lambdamikel/MIDI-80/README.md

# MIDI/80 
## A MIDI Sound & Interface Card for the TRS-80 Model 1, III, and 4 

#### Hardware & Firmware: [Michael Wessel](https://www.michael-wessel.info/) 
#### Z80 Wizardry and TRS-80 Zmac Assembler Advisor: [George Phillips](http://48k.ca/) 
#### Beta Testers: [Jürgen Wich](https://homecomputerguy.de/en/) (Model 1 Version), [Joel Hilliard (Model III / 4 Version)](https://www.youtube.com/@joelhilliard8298)
#### Project Page: [www.michael-wessel.info/hardware.html](https://www.michael-wessel.info/hardware.html#midi-80)
#### License: GPL 3

## Latest News

### September 2026

**#septandy 2026: the external clock box drives TRACKER from a real
synthesizer.**

> ✅ **TESTED ON REAL HARDWARE.** The last unproven path in the system is
> proven. A Korg microKORG sends MIDI beat clock into the clock box, the
> box turns it into parallel port step pulses, and TRACKER on a real
> Model I follows it.

[**#septandy 2026 - MIDI/80 TRACKER Updates - External MIDI Clock
etc.**](https://youtu.be/hMu7oSfEjDg) shows all of it: the external clock
running the Tracker from the microKORG, the new demo songs, and MIDORG's
visual feedback.

MIDI clock and MMC are dense, and decoding them on the TRS-80 while it is
already scanning for note-ons is not affordable. So that work moved off the
machine: an Arduino Uno with a standard MIDI shield does nothing else but
turn the incoming clock into the TTL step pulses on the parallel port that
TRACKER has understood since last year - two wires and a series resistor
into the Centronics socket.

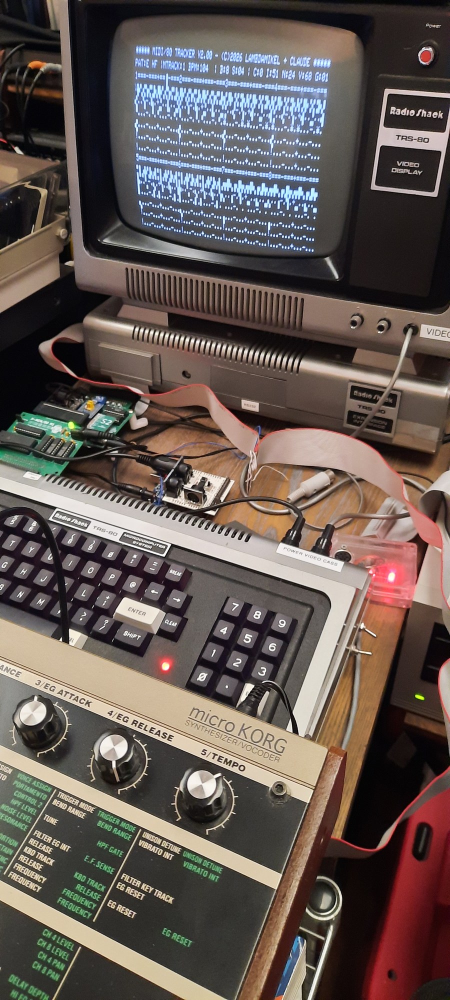
[picture p1: pics/clockbox-microkorg.jpg]
The clock box driving TRACKER on a Model I from a microKORG


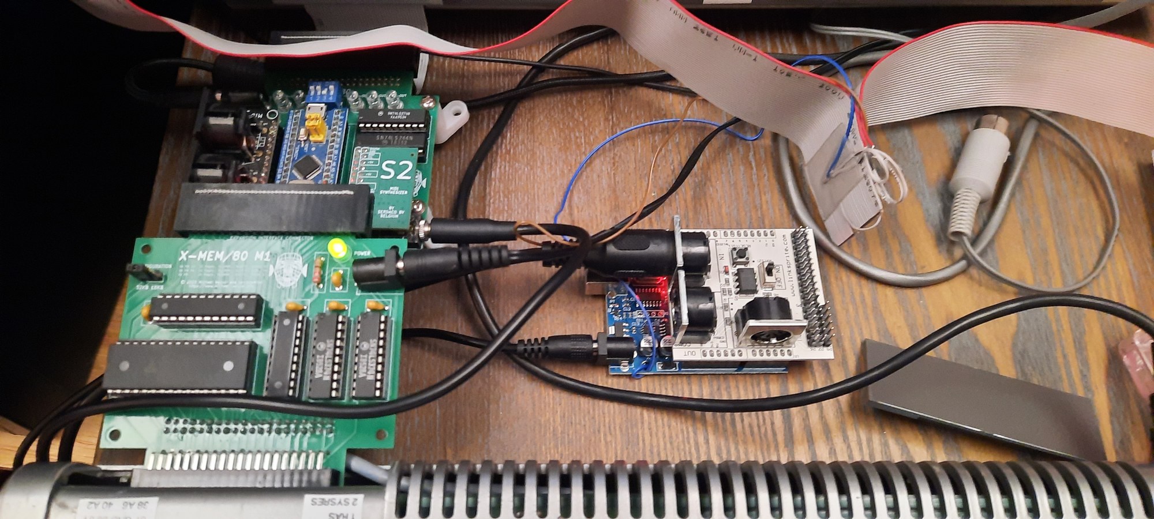
[picture p2: pics/clockbox-boards.jpg]
The MIDI/80 card, the X-MEM/80 and the Arduino clock box


The disks also carry new demo songs written with
[`tools/mksong.py`](tools/) - `BOOGIE`, `SEQUENCE`, `DRUMS` and the newest,
[`AURORA`](songs/), a Berlin school piece in D minor - and MIDORG now
lights up the keys on screen as they sound.

**TRACKER 1.99 and 2.00: MIDI clock & MMC transport output, and a much
faster tracker core.**

> ✅ **TESTED ON REAL HARDWARE.** TRACKER 2.00 has been run on an actual
> Model III driving a real MIDI/80 S2 Waveblaster module: playback,
> realtime MIDI recording, the MIDI panic and the disk prompts all work,
> and it "runs rock solid".
>
> The two concerns that were flagged here while this was emulator-only
> both came out fine, though the hardware did earn its keep:
> - **Video wait states, disabled in 2.00 on the Model III / 4** - no
>   visible hash or snow on a real CRT.
> - **The direct matrix keyboard scan** replacing the ROM call - fast and
>   pleasant for realtime note entry, and the reason recording feels
>   responsive. It did expose two real bugs that no emulator would have
>   found on its own, both since fixed: `@KEY` racing the scan (see
>   below), and command keys needing a release settle against contact
>   bounce.
>
> **Model I** has since been confirmed too, along with the keyboard fixes,
> **MIDORG V1.1**'s key highlighting, and the **`.hfe` images** booted from
> a Gotek on both machines.
>
> Each image format is verified where it is actually used: the `.hfe` files
> on real hardware, and the `.dsk` (JV3 / JV1) files under emulation, which
> is what they are for - a Gotek or HxC does not read them. Since the
> `.hfe` is produced from the `.dsk` by `hxcfe`, the filesystem inside is
> the same one either way, and booting the `.hfe` exercises it.
>
> The **external clock cable** from the Arduino clock box into the TRS-80
> parallel port has since been built, and it works: see the #septandy 2026
> entry above. Every path through the system is now hardware-verified.
>
> The tempo calibration behind the BPM readout has since been confirmed on
> hardware too: 32 bars of `BOOGIE` timed at **55.0 s** by stopwatch on a
> real Model III against **54.94 s** predicted, agreeing to within stopwatch
> accuracy. The old `BPM:` field would have implied 58.8 s for the same
> passage, nearly four seconds out - **that readout has now been corrected**
> (see below), and `BOOGIE` reads `BPM:140` rather than `BPM:130`.
>
> `TRACKER5/CMD` (V1.98) is unchanged and still on the disks as a
> fallback, but **2.00 is now the one to use** - it has been validated on
> real hardware, and it is the only version with MIDI clock output, the
> faster core and the time based tempo.

TRACKER can now act as a **MIDI master**: it transmits MIDI beat clock,
transport messages and MMC (MIDI Machine Control) over MIDI OUT, so a
DAW, drum machine or groovebox can follow the TRS-80 instead of the
other way round.

### What this means if you play live

Until now a TRS-80 running TRACKER was an island on stage: it kept its own
time, and nothing else could lock to it. With clock output it becomes the
master of the rig - press `P` and the drum machine, the groovebox and the
DAW all start with it and hold tempo with it. The `M` mode does the
reverse for setups where something else is the timing master and you only
want the TRS-80's transport to roll the other device.

The timing work matters here more than the numbers suggest. Step jitter
dropped from 1.96 ms to 0.46 ms and MIDI clock jitter from 28.75 ms to
4.40 ms, which nobody hears as such - but it is the difference between a
machine that stays locked to a drum machine across a four minute track and
one that drifts audibly out of it. The
[external clock module](firmware/midiclock-uno/) closes the loop the other
way, letting a MIDI master drive TRACKER's step clock at 0.096 ms
peak-to-peak.

**The `R` key cycles through four modes**, shown as a single character
in the status row:

| Status | Mode | What is transmitted |
| --- | --- | --- |
| (blank) | off | nothing |
| `C` | clock | `F8` timing clock + `FA`/`FC` transport |
| `B` | both | clock + transport + MMC |
| `M` | MMC only | MMC transport messages only, **no timing clock** |

The modes are separated because the two things are not equally
harmless. MMC is simply ignored by gear that does not speak it, but a
timing clock is not: anything set to external sync will start following
this machine's tempo the moment the clock appears. `M` is therefore the
mode to use when something else is the timing master and you only want
the `P` key to roll the other device's transport. (`FA`/`FC` are
suppressed in `M` as well - they are meaningless to a receiver that is
getting no clock from us.)

What gets sent, by event:

| Event | Bytes on MIDI OUT |
| --- | --- |
| Start playback (`P` or `!`) | `FA`, then `F0 7F 7F 06 02 F7` (MMC Play) |
| While playing | `F8` timing clock, 24 ppqn (6 per tracker step) |
| Stop | `FC`, then `F0 7F 7F 06 01 F7` (MMC Stop) |

MMC is addressed to device id `7F` (all call), so it reaches any
listening device without configuration.

A tracker step is a 16th note, so a quarter note is four steps and
exactly **six MIDI clocks are emitted per step**. The clock count is
drift free by construction: the downstream tempo cannot slowly walk
away from the tracker's own.

Sending rather than receiving is deliberate. Receiving MIDI clock would
mean polling the MIDI/80 FIFO fast enough never to miss an `F8`, from a
main loop whose pass duration varies by two orders of magnitude - the
tracker simply cannot observe an incoming clock precisely enough. It
*can* say exactly when its own step happened.

For the opposite direction - driving a TRS-80 **from** an external MIDI
master - there is now a companion
[**external clock box**](firmware/midiclock-uno/): an Arduino Uno with a
MIDI shield that converts incoming MIDI beat clock into the parallel
port step pulses TRACKER already understands in external clock mode.
Being dedicated, it timestamps every byte within microseconds instead
of missing clocks inside TRACKER's ~27 ms per-step blind window.

**The clock box is verified on real hardware**, on the bench and now in
place: driven by a Korg microKORG over an actual MIDI cable it tracked 276
consecutive steps with 17 microseconds of standard deviation and 0.096 ms
peak-to-peak jitter, and it has since been wired into a Model I and used to
drive TRACKER from that same microKORG.

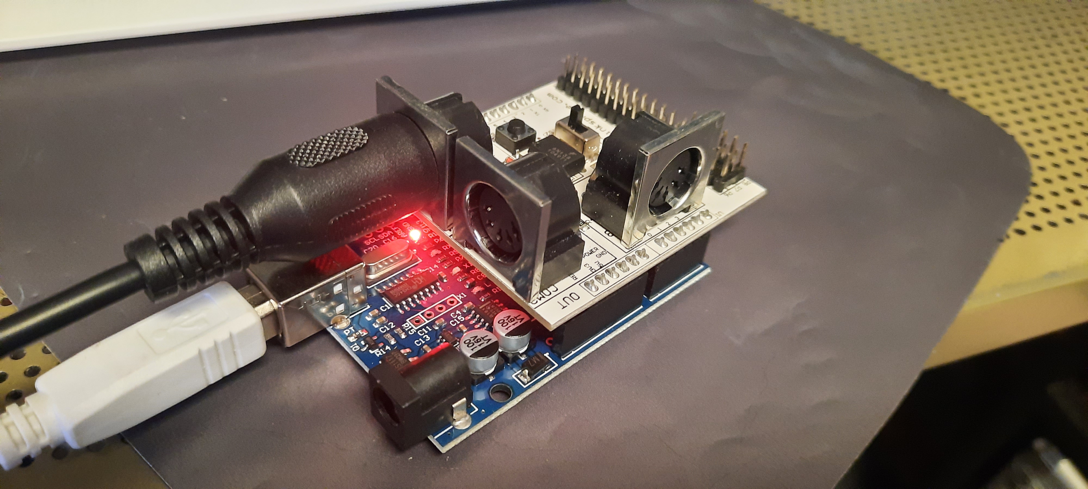
[picture p3: firmware/midiclock-uno/clock-module.jpg]
The clock module


**Wiring it is two wires**, and the series resistor is not decoration:
`D8` is a push-pull output, so if the pin it lands on ever turns out to be
an output too - a miscount on the connector, a bent pin touching a
neighbour - 220-470 Ω keeps the fight down to a few milliamps. It costs
nothing in signal integrity, since the TRS-80 input is TTL and draws
essentially no current.

```
   Arduino Uno                              TRS-80 Centronics
   -----------                              -----------------
   D8  o---------[ 220-470 ohm ]---------o  pin 21   BUSY   (input)
   GND o---------------------------------o  pin  2   GND
```

If you already built the TRS-80-to-TRS-80 sync cable, reuse it: leave the
end that plugs into the TRS-80 alone and take the two wires that went to
the *primary* machine to the Arduino instead - `Data 0` to `D8`, `GND` to
`GND`. That way you never have to identify pins on the TRS-80 side, since
that half is already proven. The [full pinout, the divisor jumpers and the
shield caveats](firmware/midiclock-uno/) are with the firmware.

**Note:** MIDI beat clock slaving is uneven across DAWs. Hardware
(drum machines, grooveboxes, most synths) follows it reliably. Ableton
Live and Bitwig are solid; Logic and Pro Tools are MTC oriented and are
poor or unsupported beat clock slaves. Check your own DAW before
relying on it.

#### TRACKER 2.00: tempo is now a real tempo

Until now `SPEED` counted main loop passes, so the step period was
whatever the work happened to cost - it changed with note density and
with anything that made the loop faster or slower. In 2.00 `SPEED` names
an actual period, and the status row shows a **real BPM readout**
instead of the raw hex delay count:

```
PAT:A SF | TRACK:1 BPM:236  | B:8 S:04 | C:0 I:01 N:24 V:7F G:08
```

The measured step period holds to a standard deviation of **0.46 ms**,
and the displayed BPM is within **0.2%** of the real playback rate.
Tempo range is roughly **60 to 550 BPM** counted in 16ths, with
`SPEED:$2A` landing at 236 BPM - about where stock 1.98 sat, so
existing songs play close to as before.

2.00 is also substantially faster, from two changes found by profiling
the step in the trs80gp bus trace:

- **Video wait states are now disabled on the Model III / 4.** They were
  costing **128 T-states per `LDIR` byte instead of 21** - a 6x penalty
  on every screen write. `showplaycursor` alone dropped from 8.02 ms to
  1.39 ms. (The Model I never executed that path.)
- **The ROM `@KBD` keyboard scan was replaced by a direct matrix scan.**
  `@KBD` was 55,836 T-states per step - about 41% of the entire step.
  The replacement costs roughly a third of that.

Together with the time based tempo these left enough headroom to hold
the clock steady: jitter between consecutive `F8` bytes came down from
28.75 ms in the first working version to **4.40 ms**, with a standard
deviation of 0.94 ms.

#### Measured improvements

All figures from the trs80gp cycle-accurate bus trace, Model III at
2.02752 MHz, empty pattern, `SPEED:$2A`. **Emulator measurements, not
yet confirmed on real hardware** (the clock box table below is the
exception - that one is hardware).

**Timing stability**

| | 1.98 | 2.00 | |
| --- | --- | --- | --- |
| Step period jitter (std dev) | 1.96 ms | **0.46 ms** | **4.3x steadier** |
| MIDI clock jitter (peak-to-peak) | 28.75 ms * | **4.40 ms** | **6.5x tighter** |
| MIDI clock jitter (std dev) | — | 0.94 ms | |
| Clocks per step | — | **exactly 6.00** | drift free by construction |
| Tempo shift when sync enabled | 17.9% | **0.1%** | **179x better** |
| BPM readout error | no readout | **0.17%** | 236 shown vs 236.4 measured |

\* the first working version of the feature, before the time weighted rewrite

**Raw speed**

| | 1.98 | 2.00 | |
| --- | --- | --- | --- |
| `@KBD` keyboard scan, per step | 55,836 T | **19,068 T** | **2.9x** (-66%) |
| `showplaycursor`, per step | 16,259 T | **2,818 T** | **5.8x** (-83%) |
| `LDIR`, per byte | 128 T | **21 T** | **6.1x** (-84%) |
| Work per step | 63.53 ms | **41.40 ms** | **1.5x** (-35%) |

The tracker does the same work in 65% of the time, which is what pays
for a real time based tempo while still leaving roughly 22 ms of slack
per step at 236 BPM. Total cost: **+808 bytes** (8325 -> 9133, +9.7%),
leaving about 2200 bytes before the data region.

**The external clock box** (hardware verified against a Korg microKORG)

| | |
| --- | --- |
| Jitter over 276 consecutive steps | **0.096 ms** peak-to-peak, **std dev 17 microseconds** |
| versus TRACKER's own clock output | **46x tighter** |
| versus TRACKER's 27 ms blind window | **281x tighter** |

**Two caveats on the numbers.** The "4.3x steadier" step period comes
from a six step sample in the profiling trace - the strongest claim in
the table and also the thinnest data; the clock jitter figures come from
runs of 130 to 280 steps and are solid. And every tracker figure is
emulator measured: cycle accurate, but still an emulator.

The two findings worth more than the table: the full screen `LDIR`
redraw that looked like the obvious suspect was **0.5% of a step** and
innocent all along, while a single commented out `and a,~$20` was
costing **6x on every video write** and the ROM keyboard call was eating
**41% of the machine**.

#### Keyboard: `@KEY` no longer races the direct scan

Reported from real hardware: pressing `H` would flash the help page for a
fraction of a second and then lose it. It looked like contact bounce, but it
reproduces exactly under emulation, where there is no bounce at all — a press
held longer than about 130 ms always loses the page, a quick tap never does.

2.00's direct matrix scan reacts to a key in roughly a millisecond, while the
interrupt-driven DOS keyboard driver only scans every 25 ms or so. Any press
held longer than one DOS scan therefore also lands in the DOS type-ahead
buffer, and the `call @KEY` that waits to dismiss the help page reads that
buffer — finding the very `H` that opened it. The same race auto-answered the
`Y/N` prompts on load, save and quit, and the copy-pattern and disk-error
prompts.

All four `@KEY` calls now use `waitkey`, which waits on the tracker's own
scan and so never consults the DOS buffer. It first insists the keyboard is
fully released, so the keystroke that opened a prompt cannot answer it.

`kbdscan` also gained a release settle (`KBDSETTLE`, ~20 ms of quiet before
the same key may be reported again), which does address genuine contact
bounce: without it the scan is fast enough to see a bouncing contact re-close
and count one press several times. The settled path costs 28 T against the 27
it replaced, so the step timing is unchanged — measured 139.68 BPM against
139.80 before, with jitter slightly improved. `datalength` is unchanged, so
existing `DUMP` files still load.

#### Stopping now silences the notes

Reported from real hardware: stop a song and notes hang until the sound
module is reset. This one is not the module's fault and not a MIDI panic
problem — the panic (the `0` key, `ALL NOTES OFF`) works fine. Stopping
simply never sent any note offs.

Both stop paths, `showstartstop` (the `P` and `!` keys) and `stopsong` (the
end of a song), sent only the `FC` MIDI Stop transport byte and set the
status flag. Any note whose note off was scheduled for a later step never
got one, so it sounded forever. Starting playback *did* call `midipanicr`,
which is why the notes cleared as soon as you started again.

Both paths now send the panic on the way out, so a stop is silent. Fixed in
1.99 and 2.00 alike; verified on the MIDI stream captured from the emulated
machine, which now shows a second 16-channel All Notes Off at the stop and
leaves nothing sounding.

#### The BPM readout now tells the truth

2.00's `BPM:` field used to be derived from `steptarget`, the value
`advanceclock` compares the step accumulator against. But the accumulator
over-counts idle main loop passes, so the real step is shorter than the
target by an amount that grows with tempo: the readout was honest around
tempo 40 and read up to 10% slow at tempo 200.

It is now derived from the measured step period instead:

```
divisor = 3893 + 97 * tempo        (16 T-state units)
BPM     = 1900800 / divisor        Model III;  1646800 Model I
```

good to within 0.3% across the whole tempo range, with the result rounded
rather than truncated. `BOOGIE` reads `BPM:140` against a true 139.8.

**`steptarget` is deliberately untouched**, so this is a display change
only - the playback timing is bit-for-bit what it was, verified as an
identical 217733 T-state step period before and after. Changing
`TEMPOBASE` would have been the wrong fix: it would have shifted the
actual tempo and de-tuned every existing song along with the demo songs.

The Model I runs about 1% slower per step in T-states than the Model III -
same code, slightly different per-model branches - which is absorbed into
the Model I constant rather than needing a second slope. Both are confirmed
on real hardware: 32 bars of `BOOGIE` timed at 55.0 s on a Model III
(54.94 s predicted) and 63.0 s on a Model I (63.4 s predicted), reading
`BPM:140` and `BPM:121` against true values of 139.6 and 121.9.

1.99 has no BPM readout, so nothing changed there.

#### Bootable disk images

Ready-to-run LDOS images containing `TRACKER5/CMD` (1.98),
`TRACKER6/CMD` (1.99) and `TRACKER7/CMD` (2.10) side by side, so the old
and new versions can be compared on the same machine:

| Model | Disk image | Gotek / HxC |
| --- | --- | --- |
| III / 4 | [`TRACKER.DSK`](trs-80/model-3/dsk/TRACKER.DSK) (JV3) | [`TRACKER_DSK.hfe`](trs-80/model-3/hfe/TRACKER_DSK.hfe) |
| I | [`tracker.dsk`](trs-80/model-1/dsk/tracker.dsk) (JV1) | [`tracker_dsk.hfe`](trs-80/model-1/hfe/tracker_dsk.hfe) |

Boot, then just type `TRACKER7` (or `TRACKER6`, or `TRACKER5`).

#### Demo songs

Three demo songs ship as ready-to-play disks that also carry `TRACKER7/CMD`
— boot, type `TRACKER7`, press `L` then `Y`:

| song | style | plays at |
| --- | --- | --- |
| `BOOGIE` | 12 bar blues shuffle in C — bass, two organ voices, lead, drums | 140 BPM |
| `SEQUENCE` | Berlin school 16th note sequencer in A minor, builds over 5 patterns | 120 BPM |
| `DRUMS` | six voice drum machine, all six tracks on channel 10 | 125 BPM |

| Model | Disk images | Gotek / HxC |
| --- | --- | --- |
| III / 4 | [`BOOGIE.DSK`](trs-80/model-3/dsk/BOOGIE.DSK), [`SEQUENCE.DSK`](trs-80/model-3/dsk/SEQUENCE.DSK), [`DRUMS.DSK`](trs-80/model-3/dsk/DRUMS.DSK) | [`BOOGIE_DSK.hfe`](trs-80/model-3/hfe/BOOGIE_DSK.hfe), [`SEQUENCE_DSK.hfe`](trs-80/model-3/hfe/SEQUENCE_DSK.hfe), [`DRUMS_DSK.hfe`](trs-80/model-3/hfe/DRUMS_DSK.hfe) |
| I | [`boogie.dsk`](trs-80/model-1/dsk/boogie.dsk), [`sequence.dsk`](trs-80/model-1/dsk/sequence.dsk), [`drums.dsk`](trs-80/model-1/dsk/drums.dsk) | [`boogie_dsk.hfe`](trs-80/model-1/hfe/boogie_dsk.hfe), [`sequence_dsk.hfe`](trs-80/model-1/hfe/sequence_dsk.hfe), [`drums_dsk.hfe`](trs-80/model-1/hfe/drums_dsk.hfe) |

The raw song files and `.MID` renderings are in [`songs/`](songs/), including
`*-TRS80.mid`, captured from the emulated machine's actual port 8 output by
tracing every `out (8),a` — so those files are literally what the TRS-80 put
on the wire. All 817 note-ons across the three songs matched the composition
on channel, note, velocity and timing.

Songs are written with [`tools/mksong.py`](tools/); the format is documented
in [`tools/README.md`](tools/). One caveat worth reading before trusting the
`BPM:` display: the readout is accurate at fast tempos but reads up to ~10%
slow at the slow end, so these songs play faster than the number on screen
says. [`songs/README.md`](songs/README.md) has the measurements.

These were built with [`tools/ldoswrite.py`](tools/), a small LDOS image
writer added for the purpose — the usual tool for this, `trswrite.exe`
from TRSTOOLS, is a Windows binary whose original download site is now a
parked domain. The `.hfe` files were produced from the `.dsk` images with
`hxcfe`, exactly as in the [midibatchconv](midibatchconv/) workflow.

Two versions are provided:

- [`TRACKER7/CMD`](trs-80/zmac/zout/tracker7.cmd) (**V2.10**,
  [source](trs-80/zmac/tracker7.asm)) - everything described above.
- [`TRACKER6/CMD`](trs-80/zmac/zout/tracker6.cmd) (**V1.99**,
  [source](trs-80/zmac/tracker6.asm)) - MIDI clock and MMC output only,
  keeping the 1.98 core: ROM keyboard scan, video wait states enabled,
  and the original `SPEED` delay count. Kept as a fallback and for the
  smallest possible change from 1.98, though the concern that motivated
  it did not materialise - see below.

**2.00 has now been tested on real hardware**, on a Model III and a
Model I. The worry recorded here previously was that disabling video wait
states might produce visible hash or "snow" on a real CRT, where an
emulator would show none. It does not: the display is clean, and 2.00 is
the version to use. A **Model 4** has not been tried, and the wait state
bit is a Model III/4 thing, so if you run one and see artifacts, 1.99 is
still there.

The keyboard scan deliberately has **no typematic repeat**: a repeating
toggle key such as `P` would flip playback on and off many times a
second. Cursor keys therefore need a tap per step. It also waits for the
contacts to stay open for about 20 ms before accepting the same key
again - without that the scan is quick enough to catch a bouncing contact
re-closing and count one press several times, which made command keys
feel hair triggered on real hardware.

### February 2026

[Joel Hilliard aka DOWNPOLY](https://www.downpoly.com/)
released his new album, `TETHER_`: 

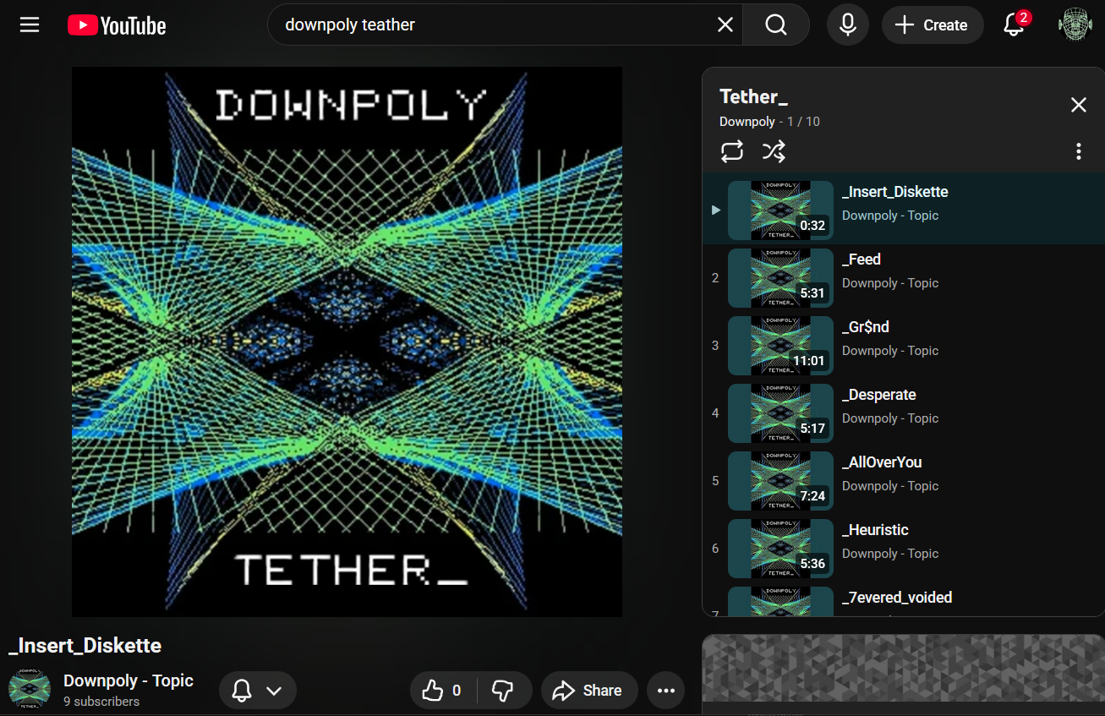
[picture p4: pics/tether_.png]
Tether


Unlike his previous album where MIDI/80 and TRACKER were 
mainly used for drums (it couldn't do more back then!), 
he is now increasingly utilizing it for full backing tracks 
on his songs (for bass, melodies, chords, ...). 
By now, TRACKER is a full-fledged 6channel multi-timbral
MIDI sequencer (organized into 26 pages which can be 
flexibly sequenced in song mode). 
More MIDI channels can be realized by synchronizing
multiple TRACKERs running on dedicated TRS-80s, 
via the parallel port sync cable (see below). Joel
is typically using 2 to 3 synchronized TRACKERS for his work. 
See below for more details. 

Please support [his work on Spotify](https://open.spotify.com/artist/7oj8N7mM6rrZCQnkTO5Ndb?si=y26EeWk6QDWjdPfHtQ730w) 
if you like [his songs on YouTube](https://www.youtube.com/channel/UCPh03Dpo_xX-oRaOAVRYgyw) (also see [here.](https://www.youtube.com/@downpoly))

### October 2025

- Playback of extremely large MIDI files is now possible - "Karn Evil
9" by "Emerson Lake & Palmer" requires 15 16 KB segments. This
requires a Gotek floppy emulator and some tricky 80-track disk
images. Thanks to folks on the TRS-80 Discord for helping me with
these. There is a new playback program
[`BIGLOAD/CMD`](trs-80/zmac/zout/BIGLOAD.CMD) which loads `/MID` files
with alphabetic suffixes (`A` - `Z`). Here are demo disks for the
[Model 1](trs-80/model-1/dsk/elp.jv3) (and
[`.HFE`](trs-80/model-1/hfe/elp.hfe)) and the [Model
III](trs-80/model-3/dsk/ELP.JV3) (and
[`.HFE`](trs-80/model-3/hfe/ELP.HFE)). An
[X-MEM/80](https://github.com/lambdamikel/x-mem-80) is required; use
the 16KB (X-MEM/80) mode. Enjoy - here is a [YT video.](https://youtu.be/6bADL48qsmo)

[Source code of `BIGLOAD/ASM`.](trs-80/zmac/bigload.asm)

To create your own very large MIDI song playback disk, just use these
disk images as blueprints and exchange the `SONGA/MID` ...
`SONGO/MID` files (you can go up to `SONGZ/MID`). The [MIDI
converter](converter/) still creates `SONG0/BIN` to `SONG<n>/BIN`
segments, so you need to rename them to be loaded with `BIGLOAD/CMD`.

### September 2025

- Playback of large MIDI files is now possible: [X-MEM/80 makes this
possible.](https://github.com/lambdamikel/x-mem-80) X-MEM/80 is a new
512 KB (paged) RAM extensions for the Model 1 and Model III that is
"plug & play", i.e., requires no hardware modifications.  Here is a
[demo video (playback of a very large MIDI
file)](https://www.youtube.com/watch?v=HZcZIu-G5TI). The details
and software as well as disk images can be found [here, on
the X-MEM/80 repo.](https://github.com/lambdamikel/x-mem-80?tab=readme-ov-file#midi80--x-mem80-software)

- [Joel Hilliard aka DOWNPOLY](https://www.youtube.com/@downpoly)
presented MIDI/80 and its software (Tracker, MIDORG, MIDI Playback
etc.) at [Tandy Assembly 2025 in Springfield,
Ohio.](https://www.youtube.com/live/VoPTrOpMQ2E?feature=shared) Great
talk, Joel! Also, a [DOWNPOLY Live
Performance](https://www.youtube.com/live/QNZUELyjySw?feature=shared)
is scheduled as well.

### August 2025

- I demoed MIDI/80 and the MIDI tracker playing a DOWNPOLY track at
  this year's Vintage Computer Festival West in Mountain View. MIDI/80
  was primarily driven by [TRS-IO++,](https://github.com/apuder) but I
  also had one connected to my Model III.  Also on display was
  [Talker/80.](https://github.com/lambdamikel/Talker-80) Here is a
  YouTube video showing [my table.](https://youtu.be/WiYWCjRBuf8)

### June 2025

- Thanks to Peter Kirn from the "cdm (create digital music)" blog for
  writing a comprehensive article about MIDI/80, Downpoly's great
  music, and the software that we wrote for it: ["Radio Shack’s TRS-80
  now has polyphonic MIDI and a
  tracker"](https://cdm.link/radio-shack-trs-80-tracker/)

- Thanks to Hackaday (Levin Day) for covering [MIDI/80 on the front page:](https://hackaday.com/2025/06/01/its-midi-for-the-trs-80/):

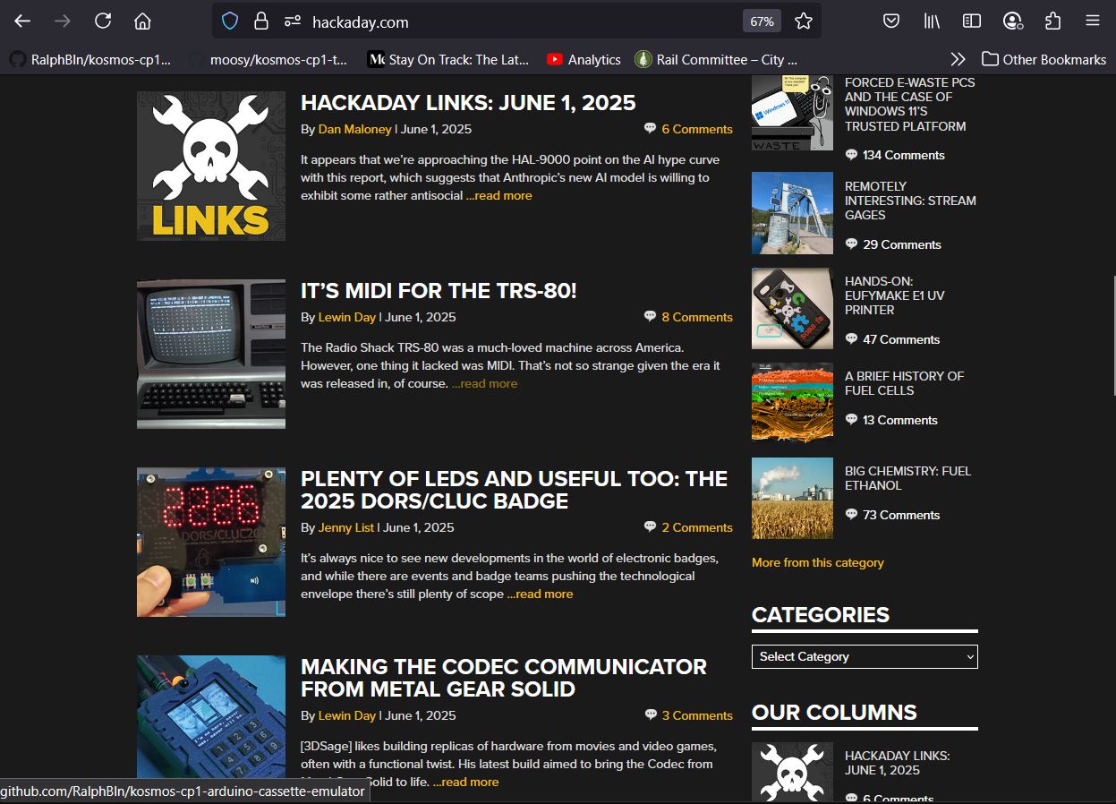
[picture p5: pics/hackaday-frontpage.jpg]
Hackaday 1


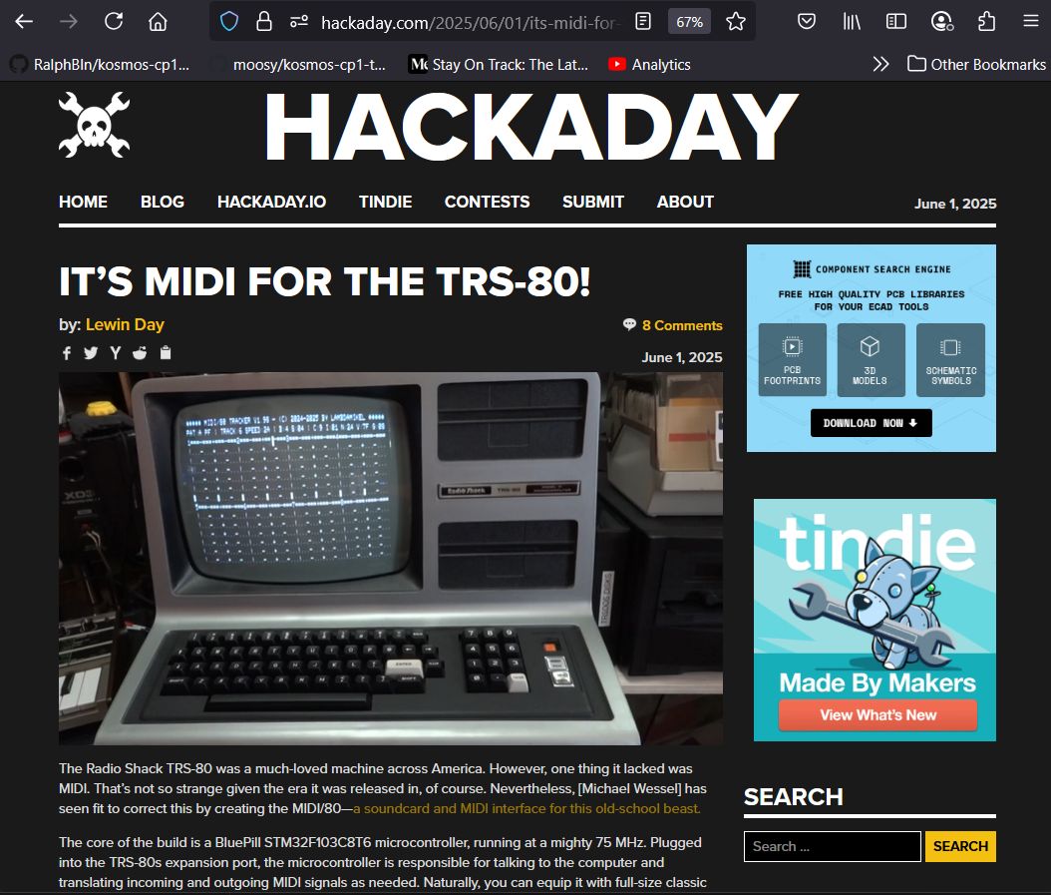
[picture p6: pics/hackaday-side-a.jpg]
Hackaday 2


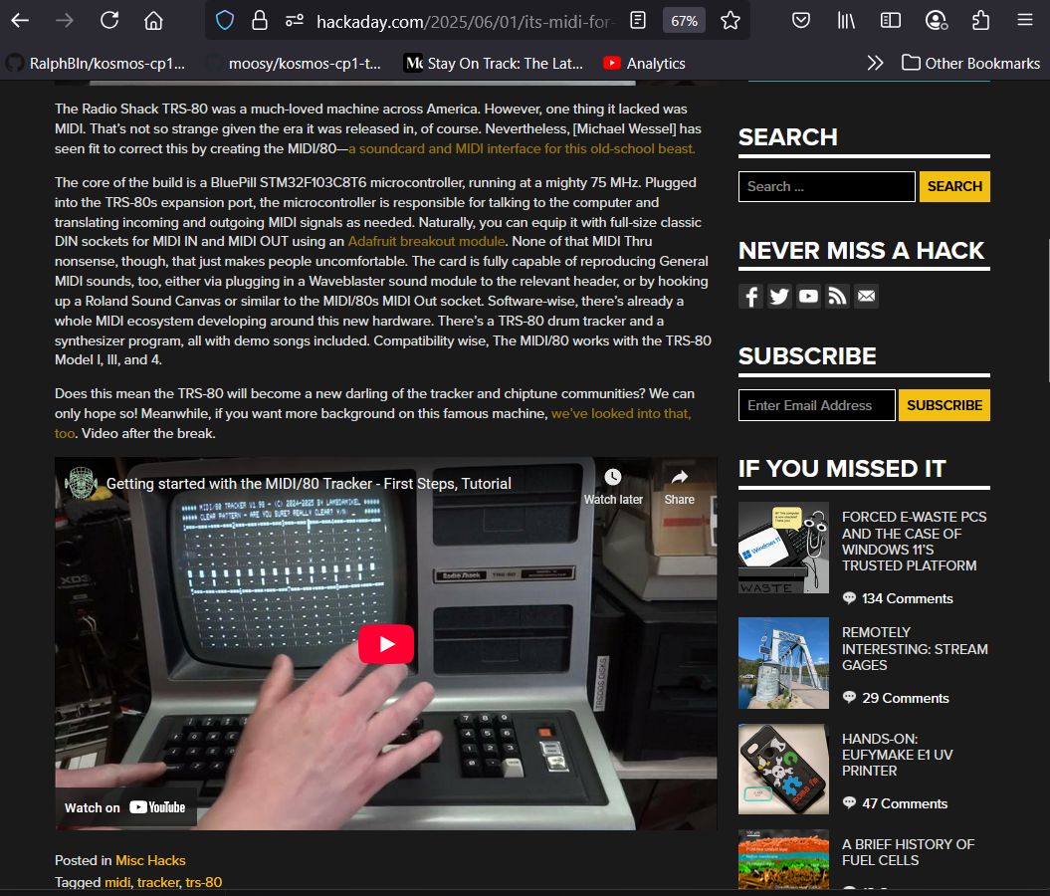
[picture p7: pics/hackaday-side-b.jpg]
Hackaday 3


### April 2025

As suggested by a recent customer, David, I have made a little
[Tracker 1.98 tutorial](https://youtu.be/nm6d1EbCBgk), good enough for 
first steps / getting your feet wet.

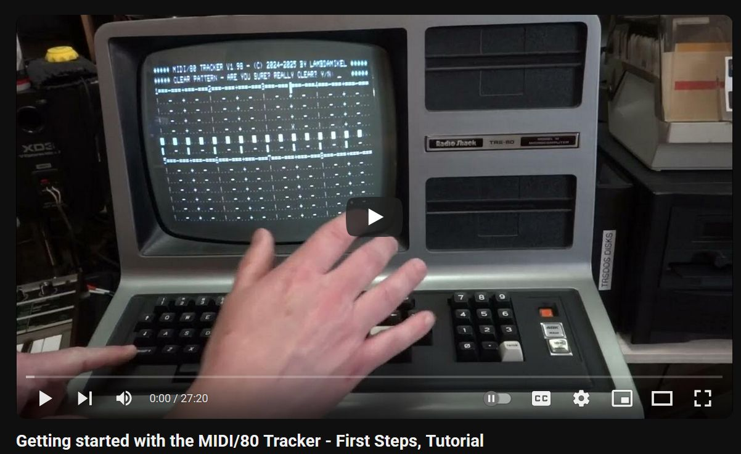
[picture p8: pics/tutorial.jpg]
Tracker 1.98 Tutorial


DOWNPOLY is using multiple Tracker 1.98 by now, synchronized over the
parallel port cable - check out [his YouTube
video!](https://youtu.be/Pxf6AB6l7uU)

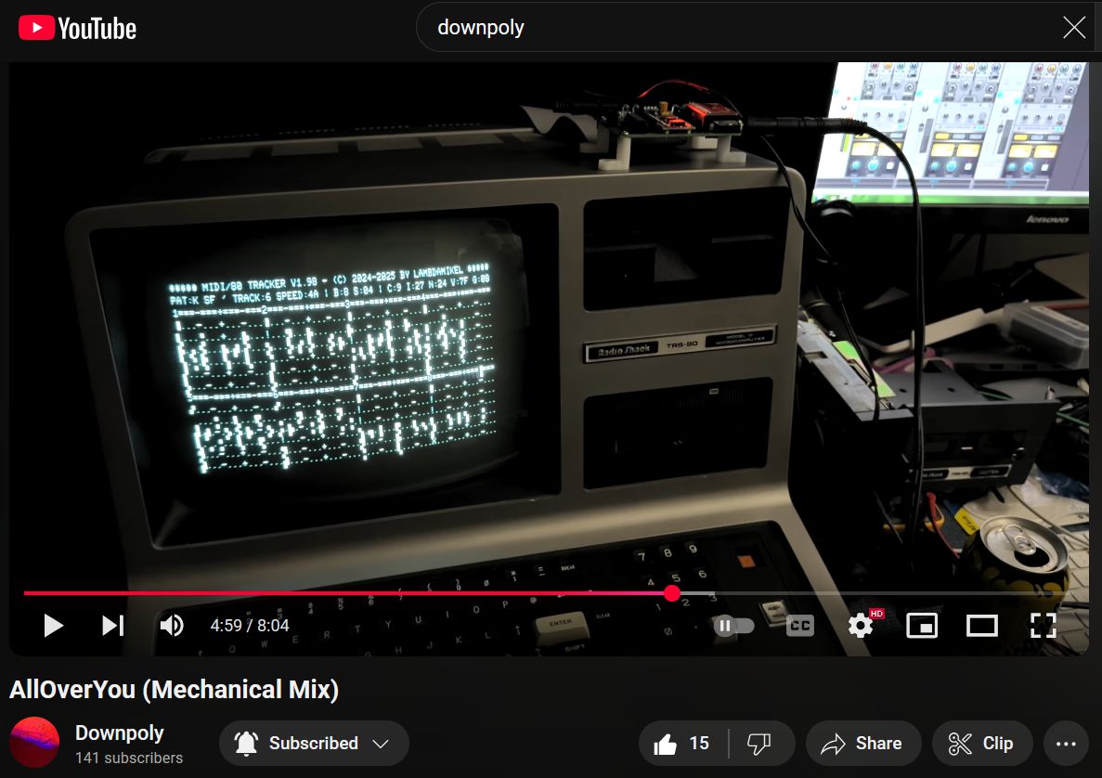
[picture p9: pics/downpoly-mechanical.jpg]
Downpoly Mechanical Mix 1


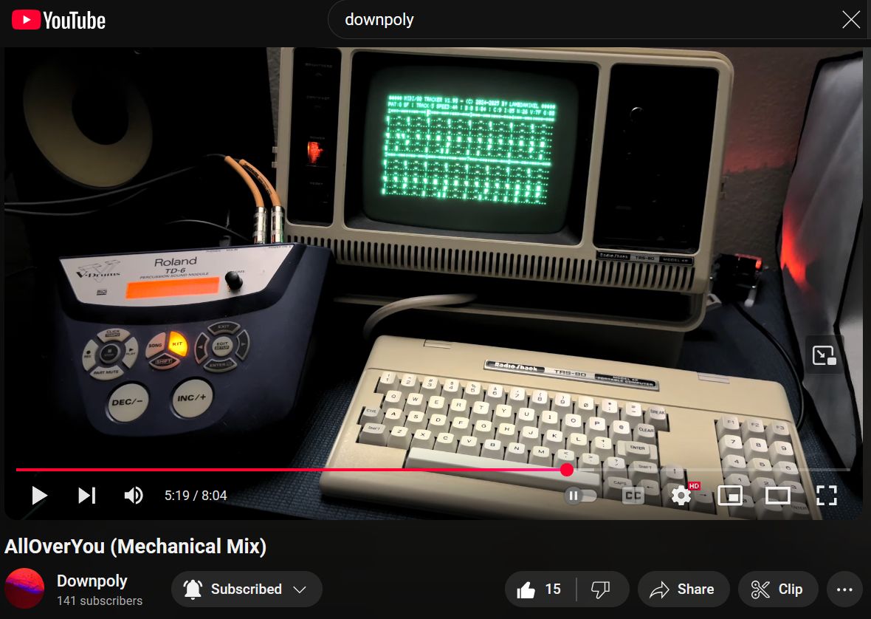
[picture p10: pics/downpoly-mechanical2.jpg]
Downpoly Mechanical Mix 2


### March 2025

It is now possible to synchronize multiple Trackers running on
different machines:

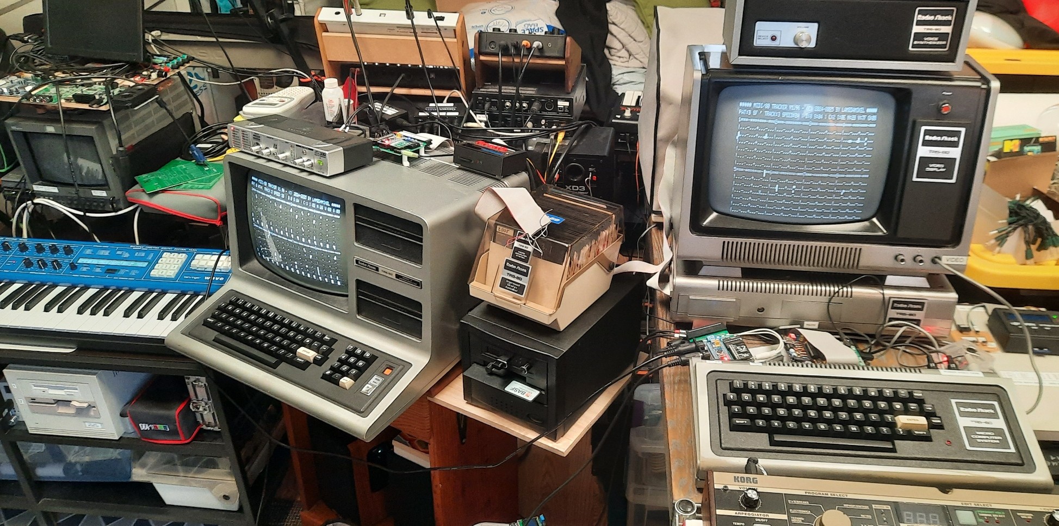
[picture p11: pics/sync.jpg]


Here is a [demo video](https://youtu.be/gPQqAGCHiV0). 

The latest version of the Tracker, Version 1.96 (`tracker5/cmd` on the
disk images) is now sending an external clock signal over the parallel
port, on `Data 0`. Another TRS-80 Tracker can then be configured to
latch on to this external clock by setting it into *external clock
mode* with the `'` key. The receiving TRS-80 Tracker is called the
secondary, and the clock generating Tracker the primary. Enable the
external clock mode on the secondary with the `'` key. Then start
playback as usual, in pattern (`P`) or song playback mode (`!`). As
usual, you can always refer to the help page for key bindings (`H`).
The secondary Tracker is frozen until it starts receiving the clock
signal from the primary Tracker via the parallel port cable; the tempo
setting of the secondary will be disregarded, as the tempo is
determined by the external clock from the primary. External clock can
be en- and disabled using the `'` at any time; also, with the
exception of the tempo setting, recording and all the other Tracker
operations and settings work identical as if the internal clock was
used.

External clock:

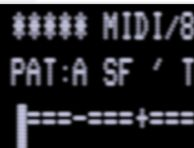
[picture p12: pics/extclock.jpg]
External Clock


Internal clock:

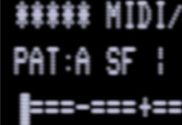
[picture p13: pics/intclock.jpg]
Internal Clock


To make the cable, simply connect the Centronics ports of the two
machines as follows: `GND` to `GND` (e.g., Centronics pin 2; note that
there are multiple options for `GND`), and the `Data 0` output
(Centronics pin 3) of the primary to the `BUSY` input (Centronics pin
21) of the secondary. And easy way to construct the cable is to cut
two TRS-80 printer cables in half, and solder the wires together: 

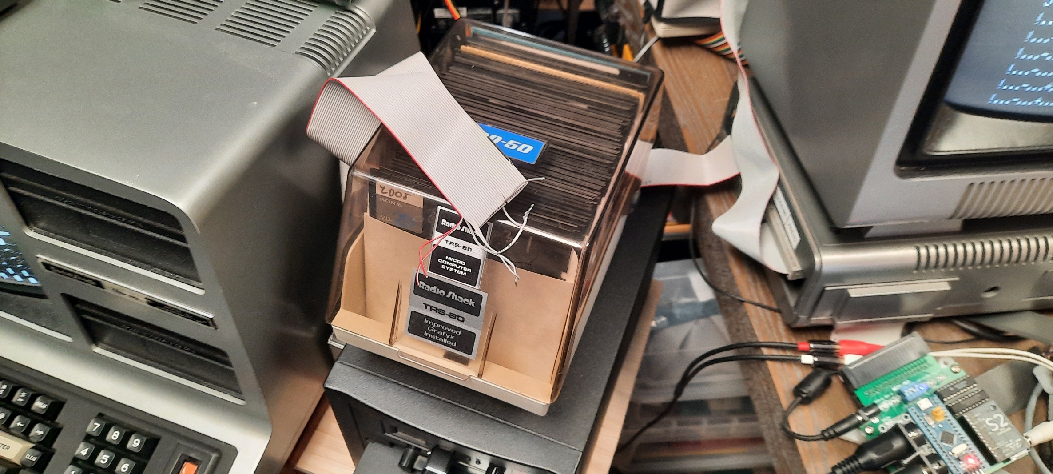
[picture p14: pics/cable.jpg]
Clock Cable


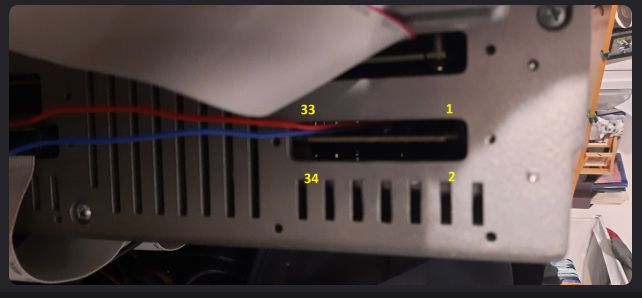
[picture p15: pics/parport.jpg]
Printer Port Model III


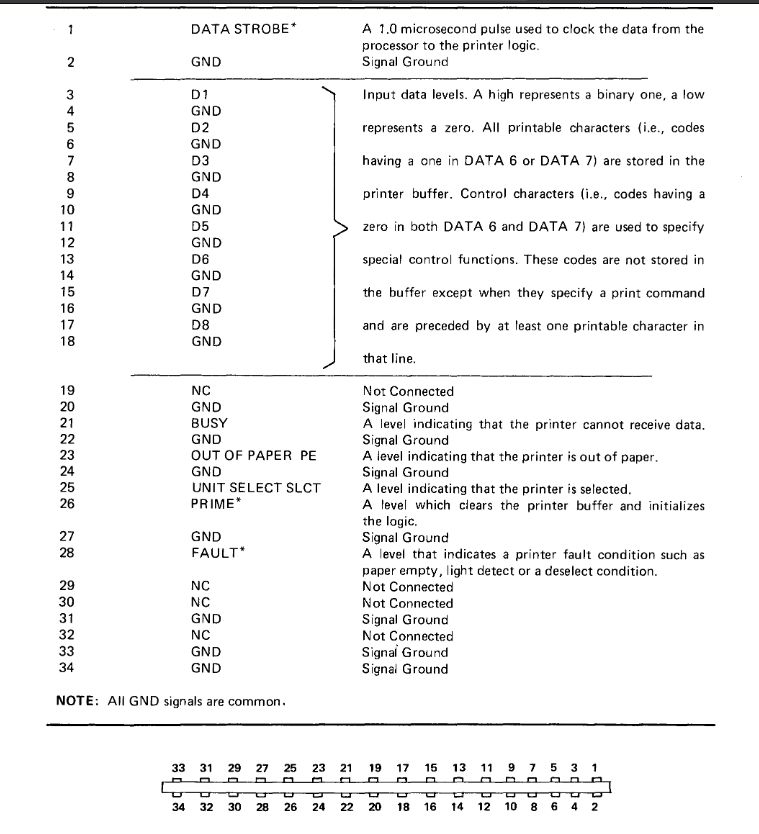
[picture p16: pics/printerport.jpg]
Printer Port Model I


### March 2025

Since March 21st I am proud owner of a Behringer Wave! I always
admired [the PPG Wave](https://en.wikipedia.org/wiki/PPG_Wave) created
back in the day in 1981 by [Wolfgang
Palm](https://en.wikipedia.org/wiki/Wolfgang_Palm), inventor of [Wave
Table Synthesis](https://en.wikipedia.org/wiki/Wavetable_synthesis),
in my birth-town [Hamburg,
Germany.](https://en.wikipedia.org/wiki/Hamburg) It's utterly amazing
what he achieved and accomplished with so little - he didn't even have
a C-compiler for software development. All the firmware / software for
his synths was programmed in bare-metal 6809 assembly.

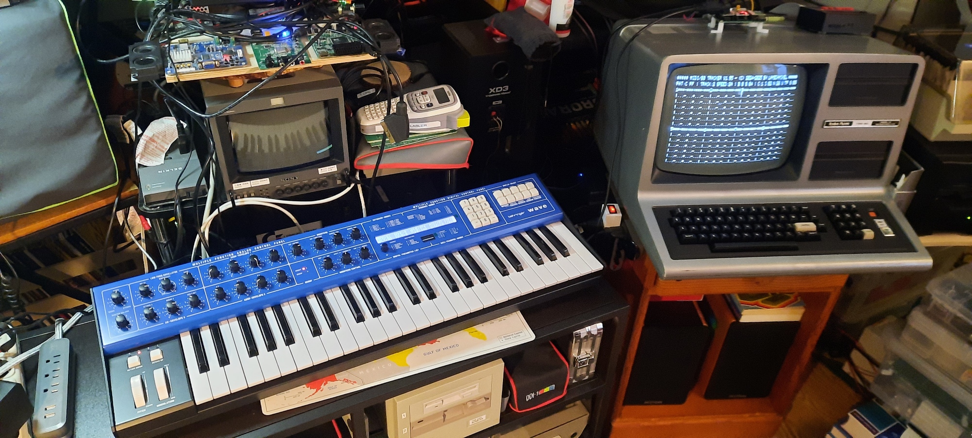
[picture p17: pics/wave.jpg]
Behringer Wave


Thanks to Behringer for cloning / re-creating the PPG Wave, and for
making it affordable! So everybody can experience the magic of this
legendary iconic influential synth now, for an extremely fair price. I
couldn't be more happy with it - the build quality is excellent
(enclosure is solid sheet metal!), the keyboard surprisingly good for
the price, and it even has aftertouch. The sound is excellent as well,
and it really reproduces the original sound quite faithfully as far as
I can tell. I believe the recreated Curtis filter chip plays a key
role here.

I am super happy with the Behringer Wave, as it allows me to make
music that sounds like Tangerine Dream and Depeche Mode from the early
1980s. [This video features my first steps with it, using Tracker 1.95
in song mode.](https://youtu.be/P_UCIXRl1cc)

### February 2025

Thanks to [Jürgen Wich](https://homecomputerguy.de/en/), who created a [new batch tool](midibatchconv/) that makes bulk creation of MIDI song disks a breeze! Check out his awesome new [MIDI Conversion Tools for MIDI/80 and TRS-80](midibatchconv/README.md)! His software tool suite can be found [here](midibatchconv/).

Thanks much, Jürgen, great work!

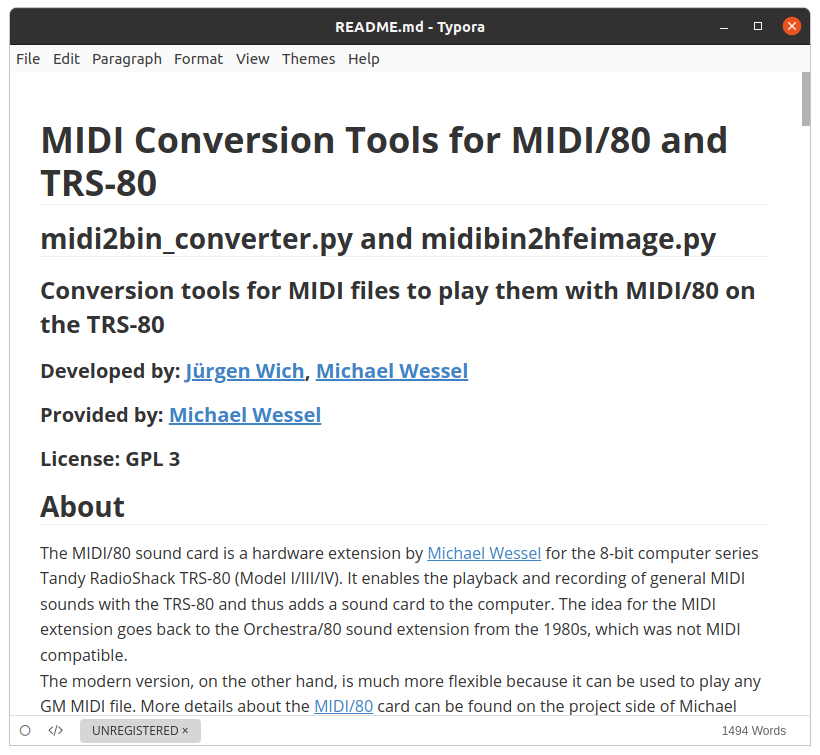
[picture p18: pics/midibatchconv.png]
MIDIBATCHCONV


### January 2025

Jürgen Wich has uploaded a demo video showcasing the MIDI/80 MIDI playback capabilities with his Model 1 - cool stuff!

https://youtu.be/vjVPdRUbgE4

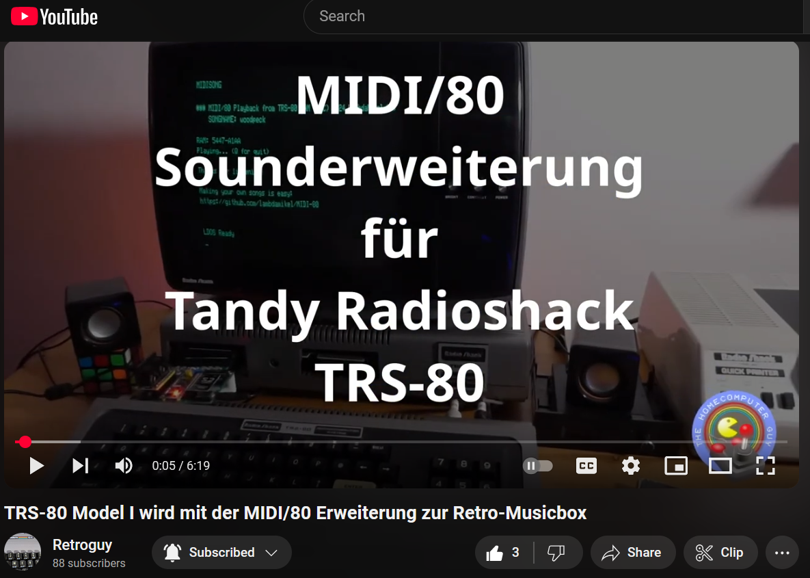
[picture p19: pics/jukebox.png]
Homecomputerguy 2


### December 2024

- Cool TRS-80 Orchestra + MIDI/80 music performance by Joel Hilliard
on the Model 4 and 4p (using `STORCH/CMD` and `TRACKER/CMD` for S2 drums). 

https://www.youtube.com/watch?v=8xH_k91aPCo

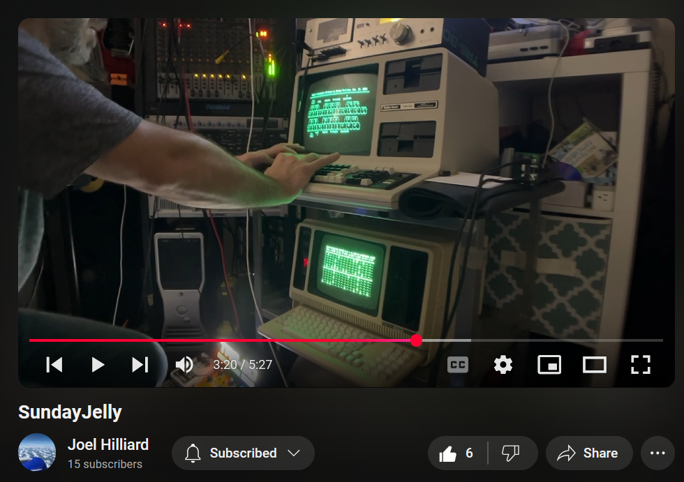
[picture p20: pics/sundayjelly.png]
SundayJelly


### November 2024 

- Jürgen Wich (the "Homecomputerguy.de") was one of the beta testers for
the Model 1 version, and has just uploaded his review - thanks, Jürgen!

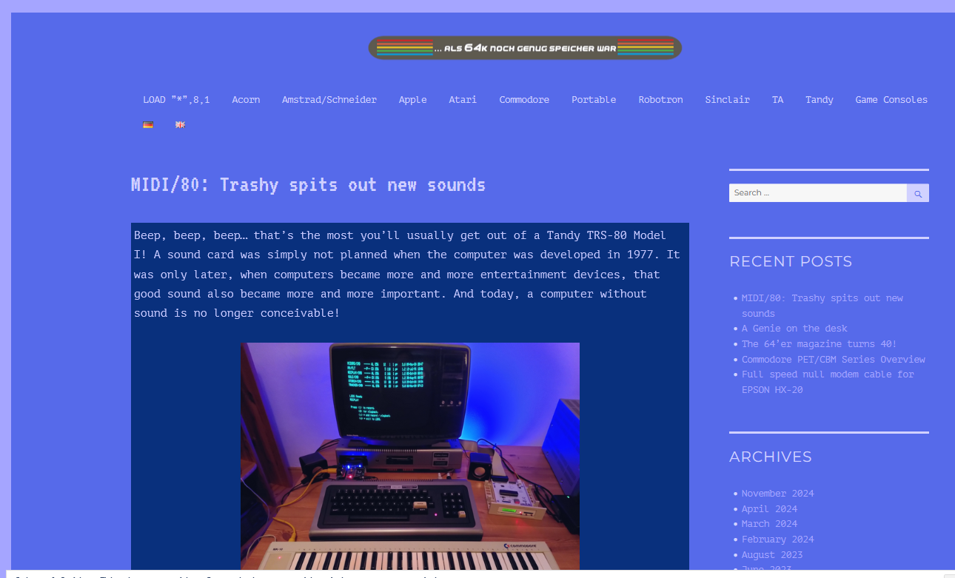
[picture p21: pics/homecomputerguy1.png]
Homecomputerguy 1


https://homecomputerguy.de/en/2024/11/24/midi-80-trashy-spits-out-new-sounds/

- MIDI/80 is *featured project* on Hackaday.com!

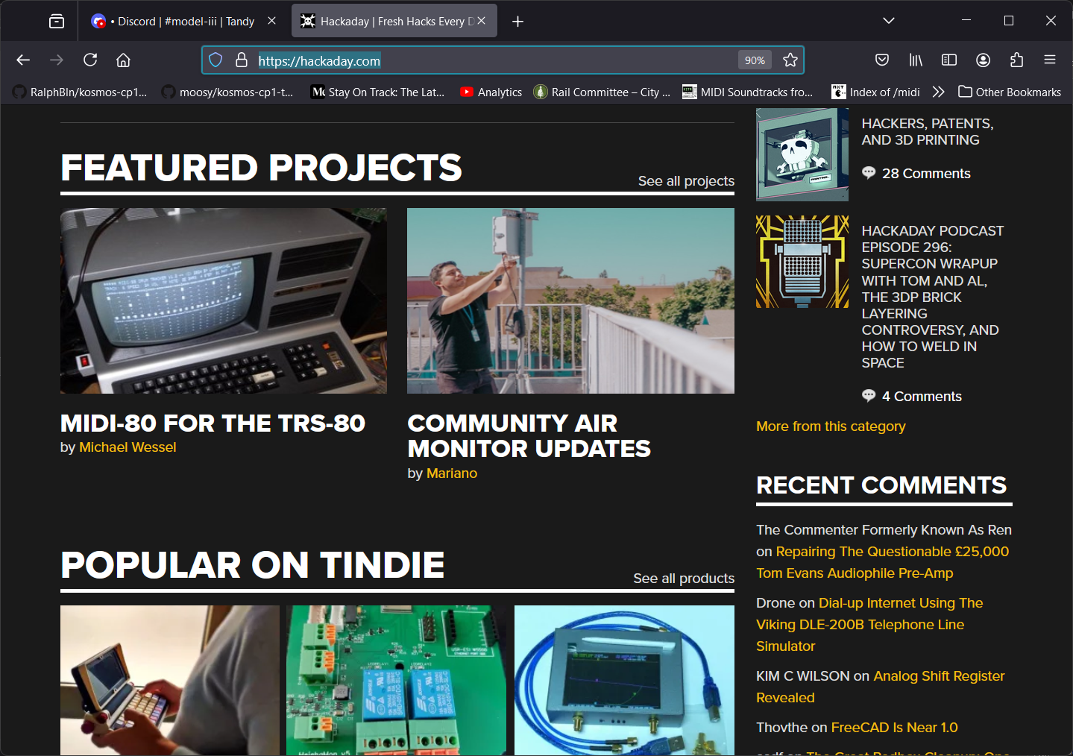
[picture p22: pics/hackaday.png]
Hackaday features


- This Github goes online. Firmware, Gerbers, and sources released to the public.
- The first beta tests were a success! Both Jürgen and Joel have successfully used MIDI/80 with their TRS-80s. 

### October 2024

[MatrixSynth](https://www.matrixsynth.com/search?updated-max=2024-10-31T14:06:00-07:00&max-results=10) posted about MIDI/80 - thanks! 

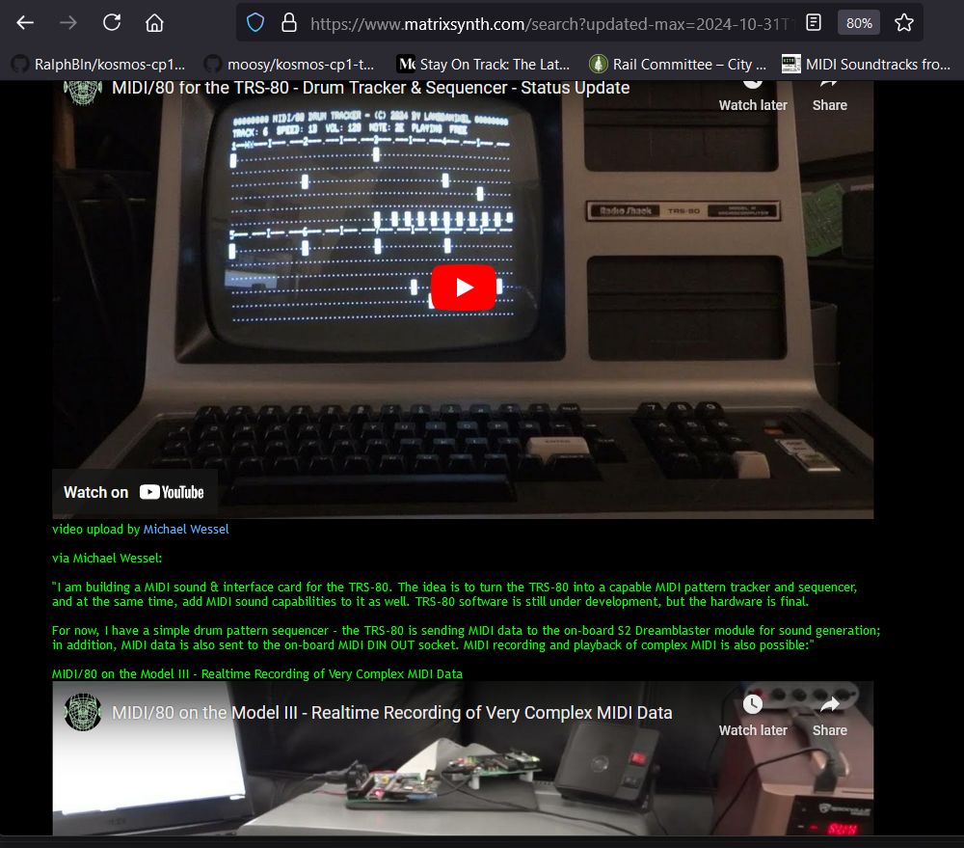
[picture p23: pics/matrixsynth.jpg]
Matrixsynth


## About

**MIDI/80 is a MIDI Sound & MIDI Interface card for the TRS-80 Model 1, III, and 4.**

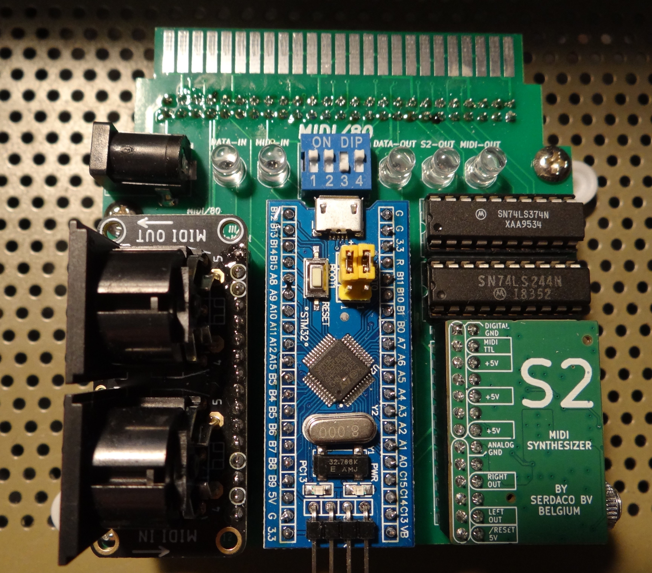
[picture p24: pics/midi80.JPG]
MIDI/80 Model 1


TRS-80 Model with Expansion Interface, MIDI/80, and Orchestra 85 replica: 

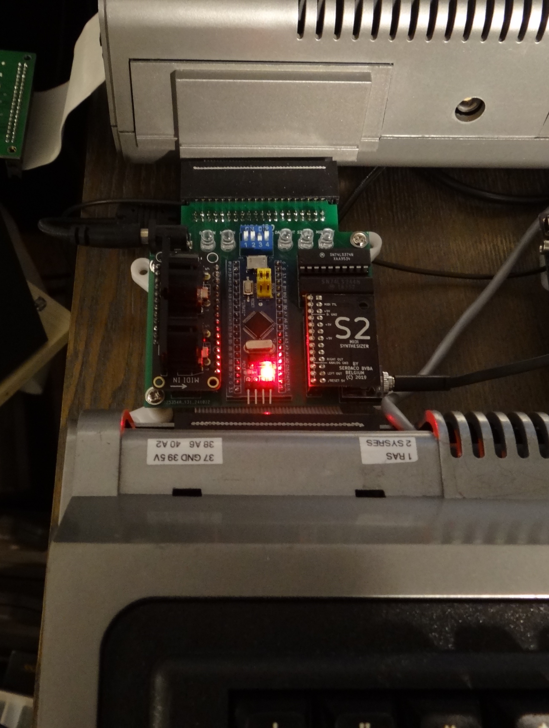
[picture p25: pics/midi80-1.JPG]
MIDI/80 Model 1


TRS-80 Model III with MIDI/80 and FreHD HD emulator connected to the
MIDI/80 expansion port pass-through edge connector:

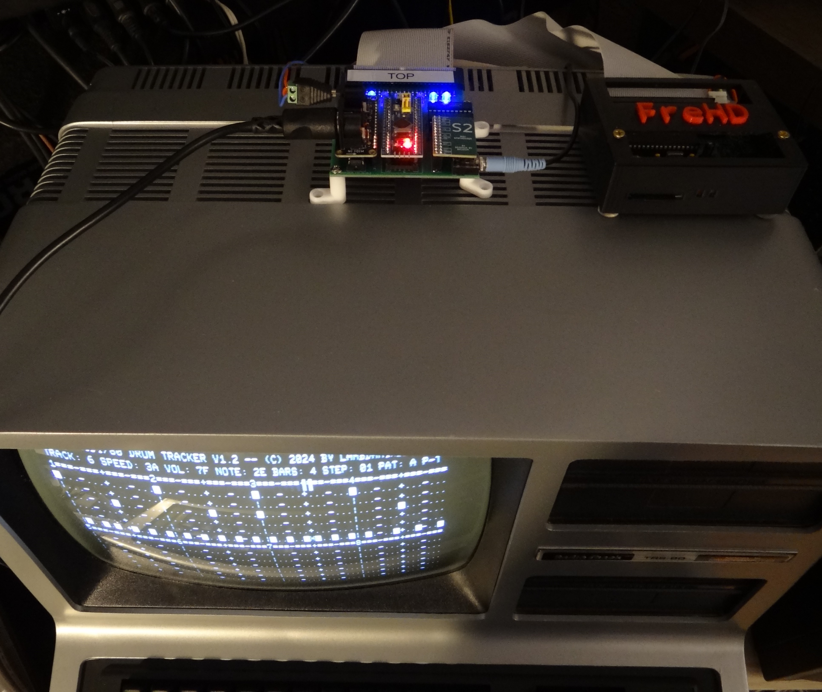
[picture p26: pics/midi80-3.JPG]
MIDI/80 Model III
 

MIDI/80 on a TRS-80 Model 4 with [TRS-IO++](https://youtu.be/tV7D6_IFSac): 

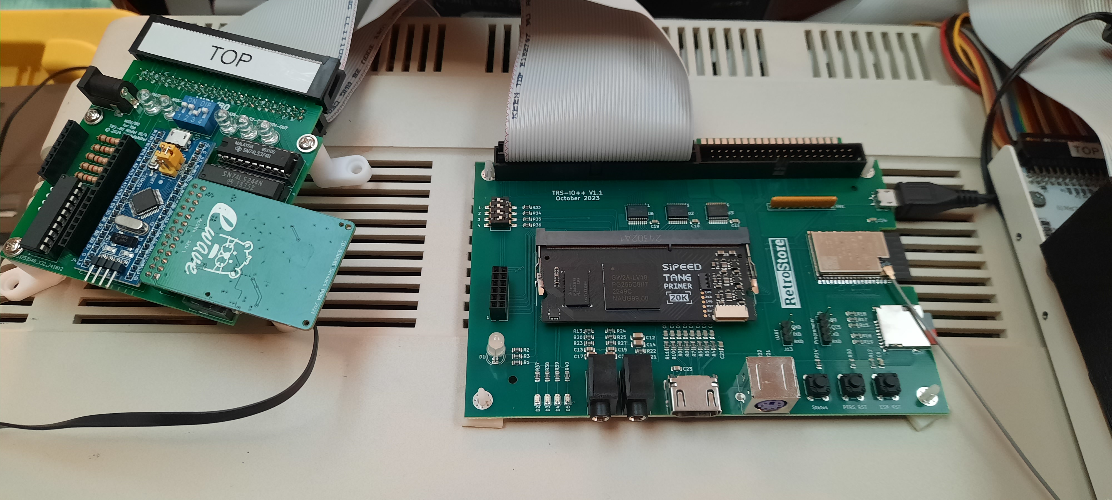
[picture p27: pics/midi80-4.jpg]
MIDI/80 Model 4
 

### Features 

MIDI/80 offers: 

- A powerful and sonically impressive, versatile General MIDI (GM)
  sound & MIDI interface card for the TRS-80 Model 1, III, and 4. 

  GM sound is either produced by a Waveblaster-compatible soundmodule
  that plugs onto MIDI/80's Waveblaster header, or via a GM expander
  (such as the Roland Sound Canvas SC-55 or Roland MT-32) connected
  to MIDI/80's MIDI OUT DIN socket. MIDI data can be sent to
  either or both of these devices. Both the Waveblaster module as well
  as the MIDI DIN sockets are optional, but in order to act as a soundcard,
  either of these options need to be present. 

- Standard MIDI IN & MIDI OUT DIN sockets (optional) turn your
  TRS-80 into a powerful MIDI processor. You can connect a standard
  MIDI keyboard to the MIDI IN DIN socket, and record MIDI messages
  with the TRS-80 into memory. MIDI messages can also be played back
  from the TRS-80 memory. The MIDI data recording is fast enough to
  allow for the real-time recording of entire multi-track complex
  GM songs, i.e., from a PC playing back a `.MID` MIDI file via
  [MIDIBAR](http://www.midiox.com/).

- Stand-alone mode: equipped with a [Waveblaster sound module](https://www.serdashop.com/RetroSoundcards), 
  MIDI/80 is also a "headless" GM expander, not unlike the Roland 
  Sound Canvas SC-55 (without display though). The MIDI/80 firmware
  provides a standalone MIDI mode - this mode is enabled
  by putting DIP Switch `3` into "ON" position. No TRS-80 is required
  in this standalone mode, only a 5 V power supply and an external
  amplifier. 

- Compatible with popular TRS-80 standard expansions: Model 1
  Expansion Interface, FreHD, Orchestra soundcards, [Talker/80](https://github.com/lambdamikel/Talker-80), etc.

- OpenSource BluePill firmware, Gerbers, and TRS-80 software available here. 

- TRS-80 software available, and more under development:
  Drum Pattern Tracker, MIDI Recorder, TRS-80 Synthesizer, etc.

- DIY friendly: only thru-hole and off-the-shelf components are used.

- Inexpensive: MIDI/80 can be assembled for ~35 USD. The most significant
  cost factor is the Waveblaster module, if required. If you already
  own an external MIDI expander such as the Roland Sound Canvas or similar,
  no Waveblaster plugin module is required.

### Technical Details 

- Requires standard 5V "wall wart" power supply; 1 to 2 Amps, center
  positive.

- Requires an external stereo amplifier to be connected to the
  standard 3.5 mm stereo audio jack. 

- Powerful [BluePill STM32F103C8T6 Microcontroller](https://www.amazon.com/gp/product/B07VKSVM21) clocked at 75 MHz (ARM Cortex-M3).

- Compatible with all Waveblaster soundcards from
  [Serdashop](https://www.serdashop.com/) that don't require a 12 V
  supply.

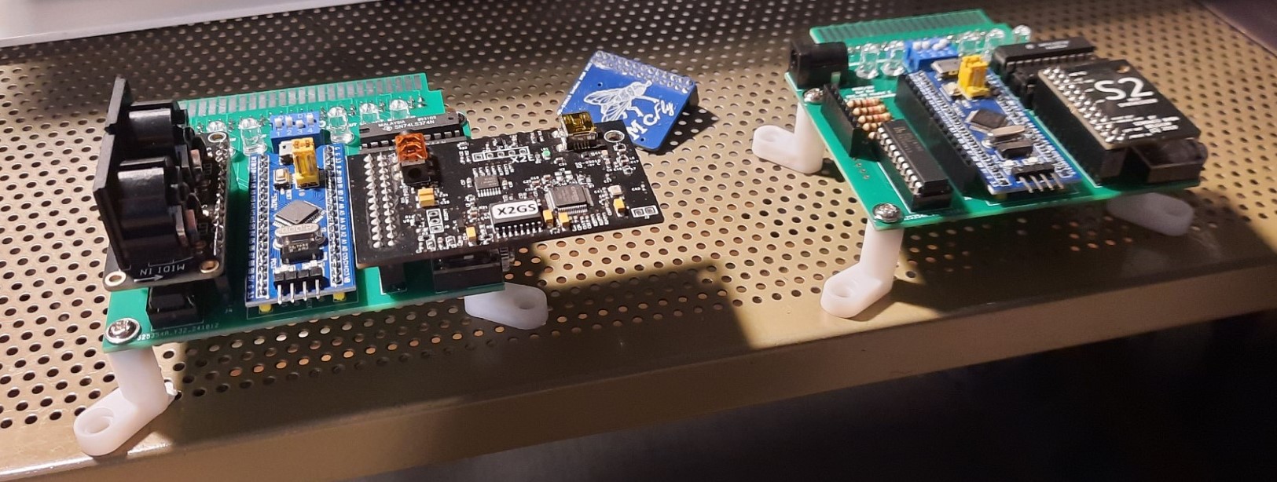
[picture p28: pics/waveblasters.jpg]
Waveblasters
  

- Uses off-the-shelf [Adafruit MIDI breakout
  module.](https://learn.adafruit.com/adafruit-midi-featherwing) The
  MIDI sockets are optional, as is the Waveblaster sound module.

- Five activity LEDs that indicate read and write activity on the
  TRS-80 IO bus related to MIDI/80, as well as incoming and outgoing
  MIDI message activity. Useful for debugging MIDI problems.

- Full TRS-80 expansion port pass-through. MIDI/80 is a "good citizen
  on the bus" and compatible with Talker/80, FreHD, Orchestra 85 and
  90, etc. 

- Reset button on the BluePill microcontroller.

## Demo Videos

You can get a better understanding of MIDI/80's capabilities and features by watching some of these YouTube demo videos: 

- [#septandy 2026 - MIDI/80 TRACKER Updates - External MIDI Clock etc.](https://youtu.be/hMu7oSfEjDg)
- ["MIDORG/CMD" - MIDI/80 TRS-80 synthesizer demo](https://youtu.be/PCqYC7ioWr4)
- [Playback of some complex GM songs from Model III RAM](https://youtu.be/CnN0iCrYn2c) 
- ["TRACKER/CMD" - MIDI/80 drum tracker demo](https://youtu.be/1idltIlOM_4)
- ["MIDORCM/CMD" - George Phillips' MIDI/80 + Orchestra organ program](https://youtu.be/yXoREGdIvFE)
- ["RECPLAY/CMD" - Realtime recording and playback of very complex MIDI data with the Model III ](https://youtu.be/S-FNLHkRXPA)
- ["RECPLAY/CMD" - Realtime recording and playback of very complex MIDI data with the Model 1](https://youtu.be/qzGTzsKHLxc)
- [MIDI/80 and external MIDI expanders - GM song playback with the Roland MT-32 connected to MIDI OUT DIN socket](https://youtu.be/-t2AQeoQEGI)

## Overview & Usage 

Connect the IDC box header at the bottom to your TRS-80 Model.

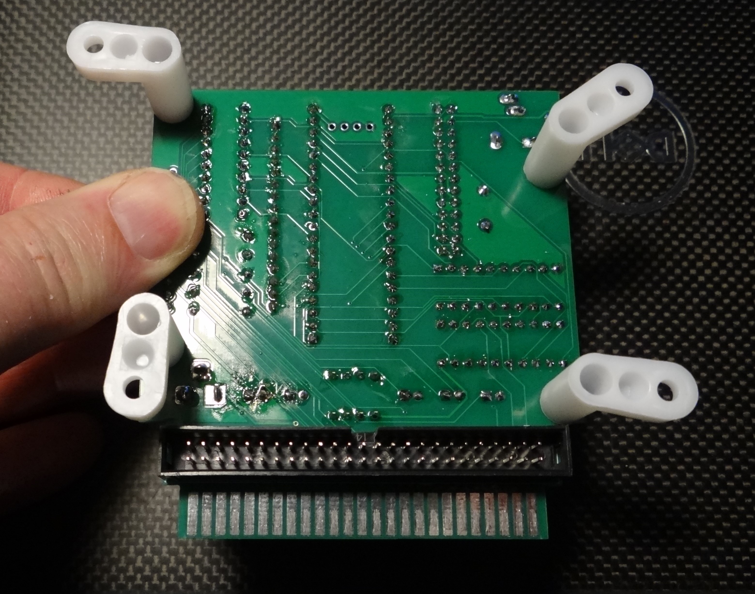
[picture p29: pics/idc-connector.JPG]
IDC Box Header Connector


Use the pass-through edge connector to connect other hardware (e.g., the
Model 1 Expansion Interface, or a FreHD) to MIDI/80.

MIDI/80 requires a dedicated external 5V standard center-positive "wall wart"
power supply (1A is sufficient).

It is recommended to power-on MIDI/80 before the other TRS-80 equipment. 

### Installation Notes 

- For the Model 1, the 40 pin ribbon cables should be as short as
possible.  If the Model 1 Expansion Interface (EI) is being used, then
MIDI/80 should be connected directly to the Model 1, and *not* to the EI
expansion port edge connector (front-left side edge connector at the
EI). See this picture for a proper setup: 

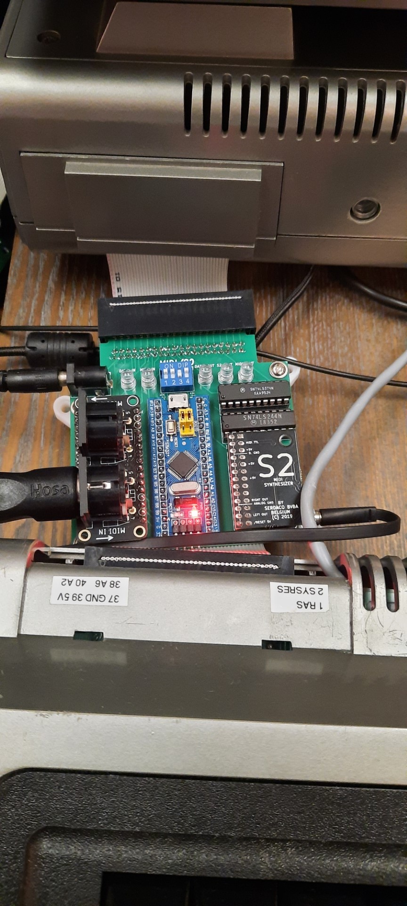
[picture p30: pics/short-cable1.jpg]
Short Cable

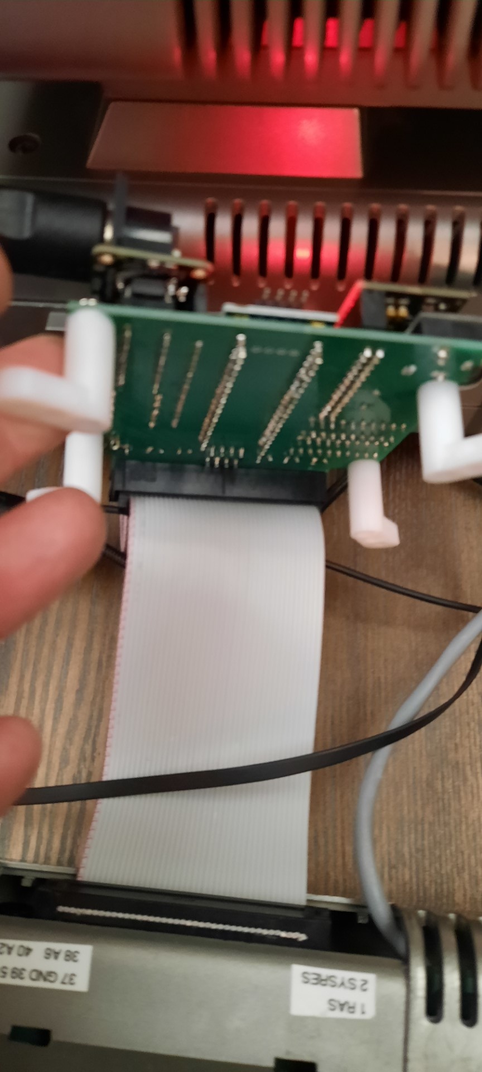
[picture p31: pics/short-cable2.jpg]
Short Cable


- For the Model III, it is convenient to place MIDI/80 directly on top
of the machine. The expansion port cable runs along the rear side of
the console, to the top. Connect additional external hardware such as
your FreHD directly to MIDI/80's pass-through expansion port edge
connector, as shown in this picture:

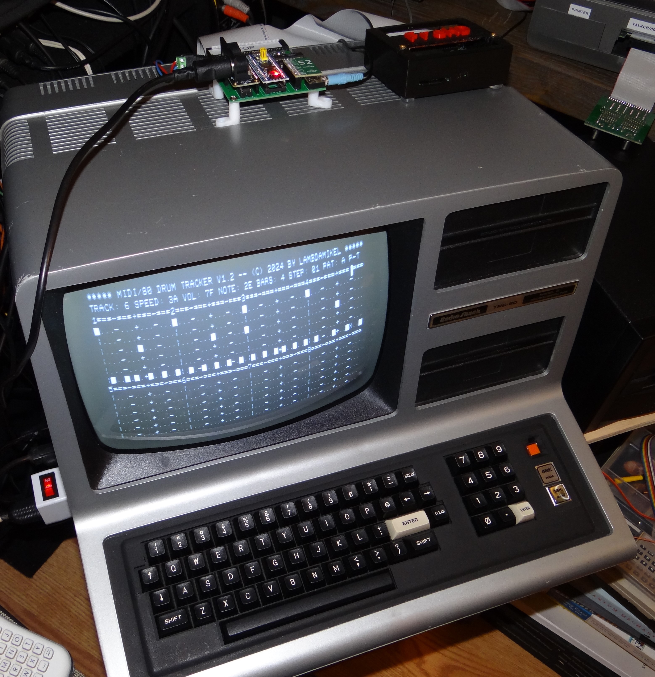
[picture p32: pics/midi80-3b.JPG]
MIDI/80 Model III b
 

*Moreover, it is important that expansion cards connected to MIDI/80's
pass-through connector use a fully connected 50pin ribbon cable!* This
is necessary in order to avoid crosstalk, as every other strand of the
50pin ribbon cable is GND. It was found that the 50pin card edge
connector of an Orchestra 90 replica board using only a 40pin ribbon
cable (hence, 10 pins of the 50pin card edge connector were left
non-connected to MIDI/80's pass-through connector, as Orchestra 90
doesn't require these signals for operations) resulted in MIDI/80
databus read failures. Switching to a fully connected 50pin ribbon
cable fully resolved the issue.

- For the Model 4, the above notes for the Model III apply. In addition
the Model 4 must be run in `SYSTEM (SLOW)` mode, as MIDI/80 only supports
the 2 MHz max CPU speed from the Model III; so the Model 4 must be operated
in Model III mode if MIDI/80 is to be used.

### Operating MIDI/80 

MIDI/80 is equipped with a **RESET button** 

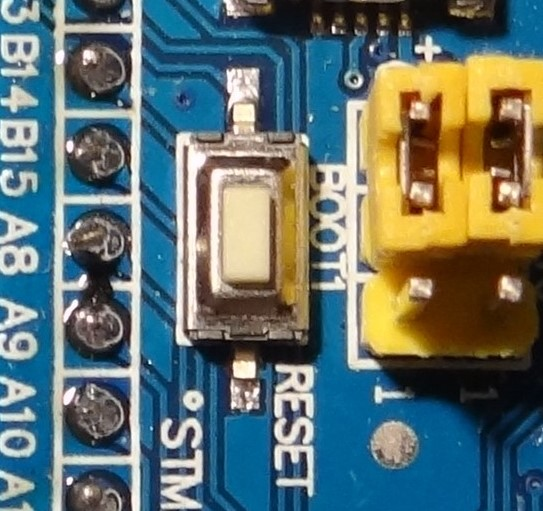
[picture p33: pics/reset.JPG]
Reset Button BluePill


a **4-position DIP switch**, and **5 activity / status LEDs:** 

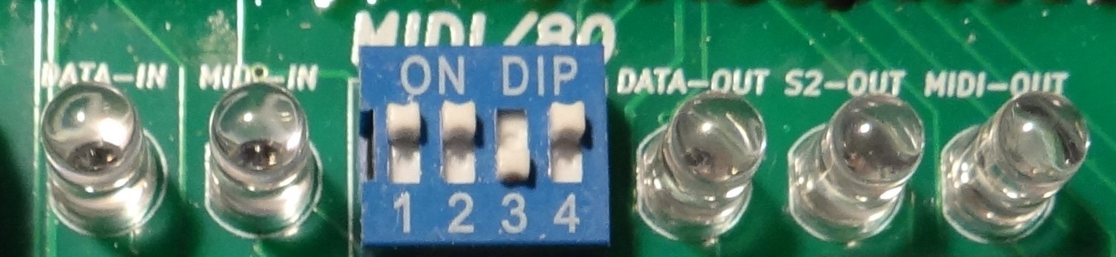
[picture p34: pics/leds-and-dip.JPG]
Five LEDS


Please note the following: 

1. **The RESET button** is on the BluePill microcontroller. 
   
   Use the RESET button at any time; the TRS-80 is not affected by a
  reset. A push to the RESET button will also reset the on-board
  Waveblaster module and clear (turn off) any potentially stuck notes.

2. The **five activity & status LEDs** indicate the following:
   - **Upon RESET / Power On,** the LEDs are tested for function and then briefly display the current DIP switch setting. 
   
      This is useful for testing
      proper operation of the DIP switch (i.e., that all switches are
      working). The default DIP SWITCH setting is `ON-ON-OFF-ON`.
  
   - At runtime, the LEDs have the following function:
     - **DATA-IN**: Data is received from the TRS-80 via IO port `8`. 
     - **MIDI-IN**: MIDI data is received via the MIDI IN DIN socket. 
     - **DATA-OUT**: Data is sent from the BluePill microcontroller
       to the TRS-80. The respective
       IO ports are `8` and `9` (see below). 
     - **S2-OUT**:  MIDI data is sent from the BluePill microcontroller
        to the internal Waveblaster connector. 
     - **MIDI-OUT**: MIDI data is sent from the BluePill microcontroller
       over the MIDI OUT DIN socket. 

3. The **four DIP switches** are used for selecting the operating mode of MIDI/80.

    **From left to right, the switches 1 to 4 have the following functions** 
    (note that there are also small labels under the buttons on the PCB
    silkscreen). In the following, `x` is either `M1` (for the Model 1
    version), or `M3` (for the Model III, Model 4 version):

   - **x --> S2**:  Determines if data received over IO port 8 from the TSR-80 
      is forwarded to the internal Waveblaster plugin module. Default setting
      is `on`. 
   - **x --> OUT**: Determines if data received over IO port 8 from the TSR-80 
      is forwarded to the MIDI OUT DIN socket. Default setting is `on`.  
   - **IN --> S2**: MIDI/80 standalone GM expander mode. Determines if data 
      received over the MIDI IN DIN socket is automatically forwarded to the
      Waveblaster plugin module. Default setting is `off`. 
      
      This is a function
      of the MIDI/80 firmware, i.e., the BluePill is doing this autonomously,
      without TRS-80 involvement. You only need a 5V power supply and an external
      amplifier, and can use MIDI/80 as a very capable GM expander module
      for your Waveblaster sound module with this mode. 
   - **IN --> OUT**: Determines if data received
      over the MIDI IN DIN socket is automatically forwarded to the
      MIDI OUT DIN socket. 
   
      This, again, is a function 
      of the MIDI/80 firmware, i.e., the BluePill is doing this autonomously,
      without TRS-80 involvement. It basically implements a MIDI THRU
      function; note that this function is not exclusive to the MIDI OUT
      socket. The TRS-80 can also still send out data over it. 

**Note: After a change to the DIP switch, a RESET is required in order
for the change to become effective (use the RESET button on the
BluePill).** 

### Operating System Notes

On all systems, *LDOS 5.3.1* is the default operating system for which
the software is developed. Model 4 users must configure their machine
via `SYSTEM (SLOW)` for MIDI/80.

The MIDI/80 programming examples in BASIC are written in LBASIC (LDOS
BASIC) and are not guaranteed to work with the other BASIC dialects.

All other programs are written in Z80 assembly using George Phillips'
Zmac assembler and `trs80gp` emulator as development toolchain.

### Important Notes for FreHD Users

If you are using MIDI/80 and the provided example programs with a
FreHD harddisk emulator, then the following important information
applies to you. Else, if you boot LDOS from Gotek / disk drive,
you can ignore this section. 

Thanks to **Matthew Boytim** for figuring out the following mystery:
the MIDI/80 playback programs (e.g., `CANYON/CMD` demo song) run about
~32 % faster if started and run from a FreHD LDOS, compared to an LDOS
booted from disk / Gotek.

The reason is the keyboard driver; **to ensure equal playback speed,
please enter `RESET *KI` before starting the playback program (e.g.,
`CANYON/CMD`) if a FreHD LDOS is used!** 

Moreover, the FreHD ROM / image also loads certain drivers into high
memory regions, which would be overwritten by large demo songs such as
`TOCCATA/CMD`. This song causes a `SYS ERROR` if executed from FreHD
LDOS. Hence, it only runs from Gotek / floppy disk LDOS.

## Theory of Operation

MIDI/80 implements a FIFO queue with a capacity of 256
bytes for buffering incoming MIDI messages which are received over the
MIDI IN DIN socket. The status of this buffer can be queried by reading from IO
port `9` - a `1` indicates MIDI bytes are queued for retrieval from the
buffer, and a `0` indicates an empty buffer. MIDI bytes can then be
retrieved from the FIFO by reading from IO port `8`.

If the standalone mode is turned on, i.e., DIP switch `3` is set to on,
then all MIDI data bytes received over MIDI IN are also automatically
forwarded to the Waveblaster module. 

If MIDI THRU is turned on, i.e., DIP switch `4` is set to on, then MIDI
data bytes received over MIDI IN are also automatically forwarded to
the MIDI OUT DIN socket.

MIDI data bytes received by MIDI/80 from the TRS-80 via port `8` will
not be buffered, but, depending on the settings of DIP switches `1` and
`2`, immediately be forwarded to either the Waveblaster plug-in module,
and/or the MIDI OUT DIN socket, or both or none. Both routes can be
turned on or off individually, and independently of each other.

MIDI/80 is implemented using 4 ISR (Interrupt Service Routines).
There is a pair of ISRs for handling reads and write to TRS-80 IO port
8, and one ISR for handling IO port `9` reads. Another ISR is
responsible for putting MIDI bytes received via the MIDI IN socket
into the FIFO buffer. The MIDI ISR has priority over the ISRs serving
the TRS-80 IO - the Z80 CPU may be put into WAIT state in case these
events happen concurrently.

The BluePill does the heavy lifting, but requires some help from 
three additional glue logic support chips in order to meet the 
strict bus timing constraints of the TRS-80 with a "not quite 
fast enough" microcontroller such as the BluePill @ 72 MHz: 

- A **GAL16V8** is primarily used as an address decoder for IO ports `8` and `9`. It notifies the BluePill and triggers the appropriate ISRs. It also implements some glue logic for driving the other two support chips. 
- A **74LS244** is used to decouple TRS-80 databus read requests from the BluePill databus. 
- A **74LS374** is used to decouple TRS-80 databus write requests from the BluePill databus. 

In combination, the 74LS244 and 74LS374 greatly relax the 
timing constraints on the BluePill ISRs. Without them, the design would not work. 

## MIDI/80 Software for the TRS-80

Note that many of these programs are demonstrated on the YouTube
MIDI/80 channel (see above). 

There is a set of [MIDI/80 song disks](trs-80/) containing GM songs for
playback, simply for listening pleasure.  These also serve as
standalone demos. See below for info on how to make your own songs for
MIDI/80.  The software is under development, and there might be
frequent or infrequent updates in the future.

The programs on the [`MIDI80.DSK`](trs-80/model-3/dsk/MIDI.DSK), [`MIDI80_DSK.HFE`](trs-80/model-3/hfe/MIDI_DSK.hfe) Model III disk images are:

- `ALF/CMD`, `TOCCATA/CMD`: MIDI Demo songs; playback of complex GM data from TRS-80 RAM. 

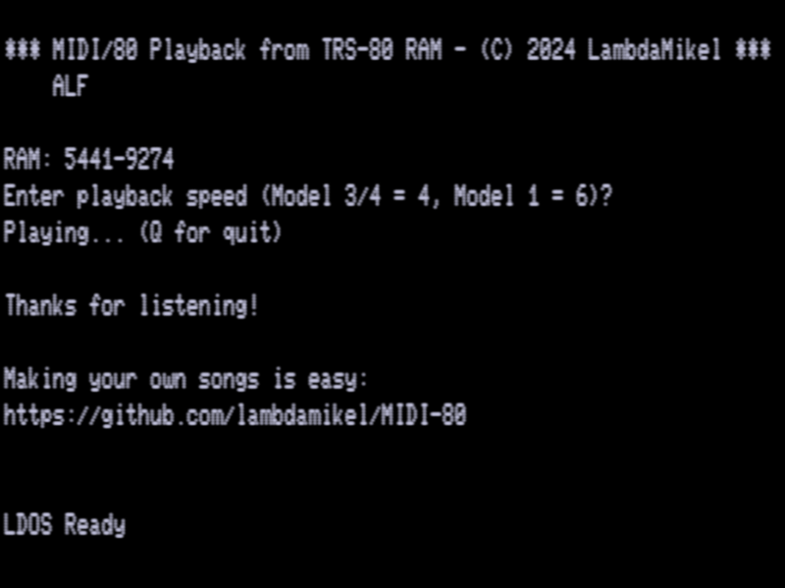
[picture p35: pics/alf.gif]
Alf Demo Song
  

- `MIDORG/CMD`: Turns your TRS-80 into a full-blown polyphonic
multitimbral MIDI keyboard. You can play the Waveblaster (S2) or an
externally connected GM expander with your TRS-80 keyboard. This is
joint-work with George Phillips, as the program uses his keyboard
scanning and self-modifying key handler code. 

  V1.1 is hardware tested, and is on
  [`MIDI.DSK`](trs-80/model-3/dsk/MIDI.DSK) /
  [`MIDI_DSK.hfe`](trs-80/model-3/hfe/MIDI_DSK.hfe) (Model III) and
  [`midi.dsk`](trs-80/model-1/dsk/midi.dsk) /
  [`midi_dsk.hfe`](trs-80/model-1/hfe/midi_dsk.hfe) (Model I), replacing the
  V1.0 build that was there before. It lights up the on-screen keyboard as you play: a held key fills
  its box on the virtual keyboard, and releasing it restores the note
  name. Neither the Model I nor the Model III has a reverse-video
  attribute for text - `$C0`-`$FF` is a symbol set on the III and a
  second copy of the block graphics on the I - so the highlight is
  drawn with solid graphics blocks, which is as close to inverse video
  as the hardware gets. The `*` markers that used to sit permanently
  in each key box are now what tells the program where the boxes are:
  at startup it scans the artwork for them, records each box position
  and width, and blanks them. Adding or moving a key in the artwork
  therefore needs no table changes, only a marker and its id. The idea
  and the marker-scanning approach are George Phillips', from his
  STORCH Orchestra-90 organ program.

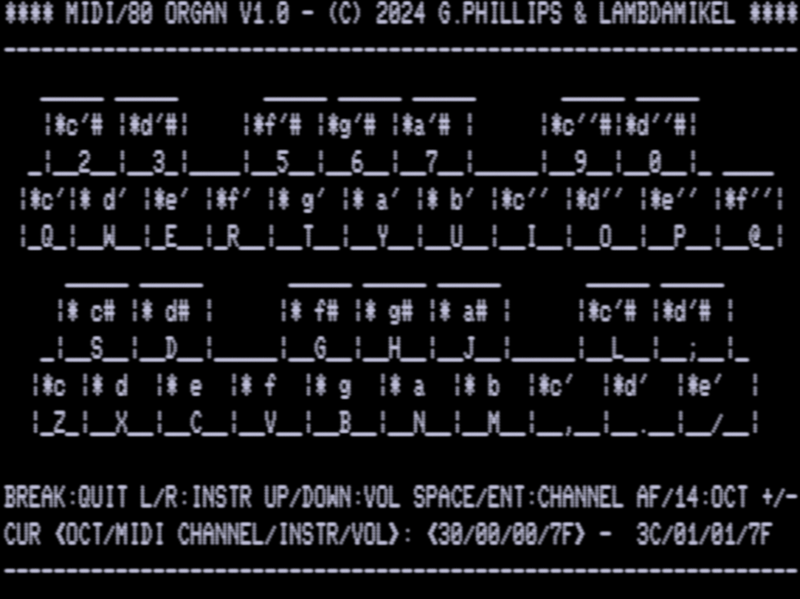
[picture p36: pics/midorg.gif]
MIDORG
  

- `TRACKER/CMD`, `TRACKER1/CMD`: A drum pattern sequencer for your TRS-80. `TRACKER1/CMD` allows realtime tracking / recording over the MIDI drum channel (10) from a
  connected MIDI keyboard / synthesizer (via MIDI IN). 

  `TRACKER5/CMD` (V1.98), `TRACKER6/CMD` (V1.99) and `TRACKER7/CMD`
  (V2.10) are the current 6 channel multitimbral versions. 1.99 adds
  MIDI clock and MMC transport output (`R` key); 2.00 additionally
  makes the tempo time based, shows a real BPM readout, and runs a
  faster core. See the September 2026 news entry above. 

  **A note on realtime recording (all TRACKER versions, and the CPC port
  as well):** a recorded note takes its length from the track's Gate Time
  setting, not from how long you held the key - TRACKER records MIDI NOTE
  ON, and generates the NOTE OFFs itself during playback. It does read
  NOTE OFF while recording, though, so that what you hear follows your
  hands: releasing a key silences the note the recording echo is holding,
  which keeps an organ or a pad from droning on the last note you played.
  A keyboard that sends NOTE ON with velocity 0 in place of a NOTE OFF is
  understood as well - otherwise every key release would be recorded as a
  second note.

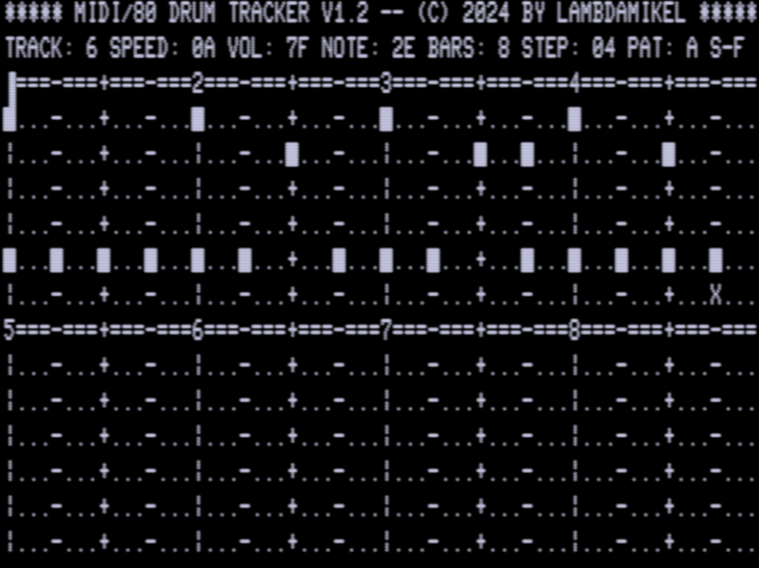
[picture p37: pics/tracker.gif]
TRACKER
   

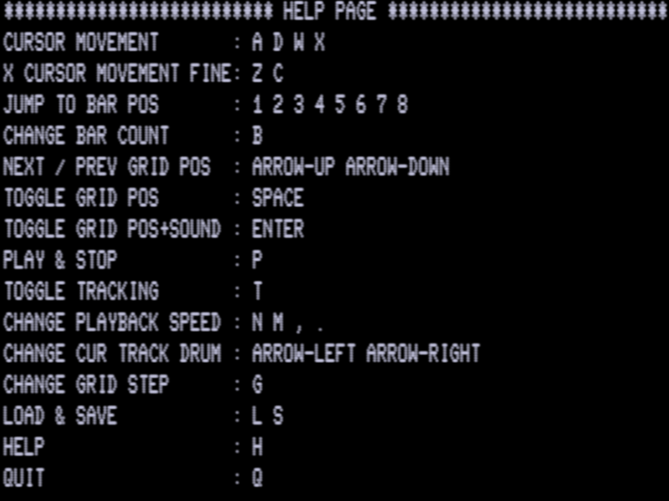
[picture p38: pics/tracker2.gif]
TRACKER2
   

- `RECPLAY/CMD`: A MIDI data recorder and MIDI data playback device. You can record the incoming MIDI IN data stream into TRS-80 RAM, and play it back from there. This program is fast enough to support real-time recording of entire complex GM songs, as demonstrated in [this demo]. In a future version, it will be possible to save (resp. load) the recorded MIDI data (GM songs) to (resp. from) disk.  

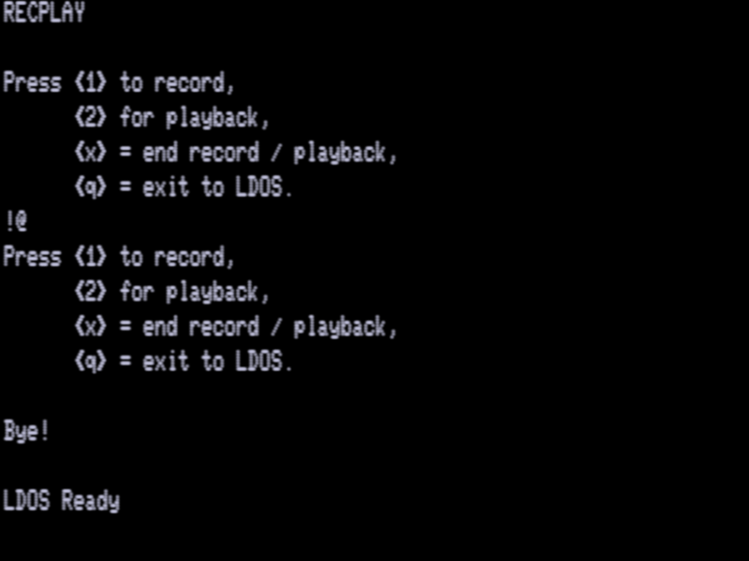
[picture p39: pics/recplay.gif]
RECPLAY
   

- `DRUMS/CMD`: A simple program demonstrating how to program MIDI/80
  with Z80 assembly language. Use your TRS-80 keyboard to play the
  MIDI drum channel (channel 10). The ASCII codes of the keys are
  mapped to instrument numbers.

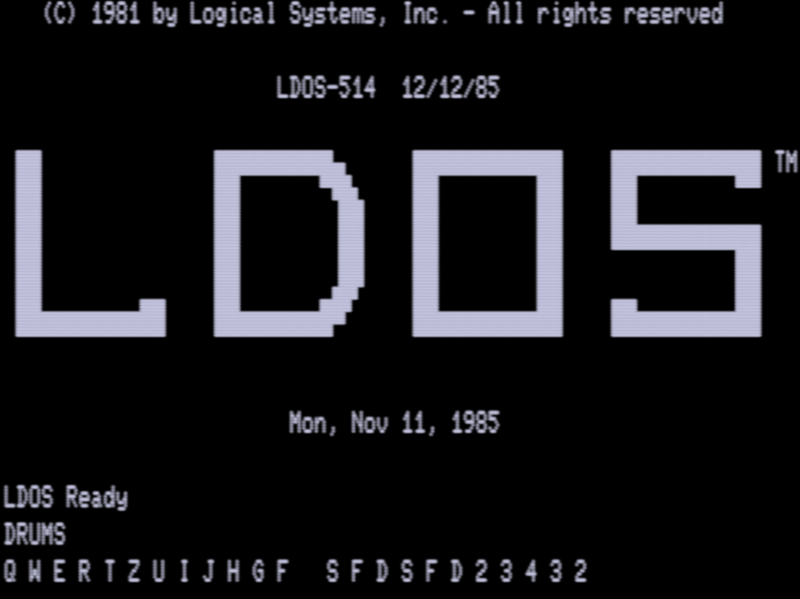
[picture p40: pics/drums.gif]
Drums
   

- `MIDIMON/BAS`: A simple MIDI monitor. Prints MIDI data bytes to the 
  screen. Useful for debugging
  MIDI issues. Also demonstrates how to query the FIFO buffer from LBASIC. 

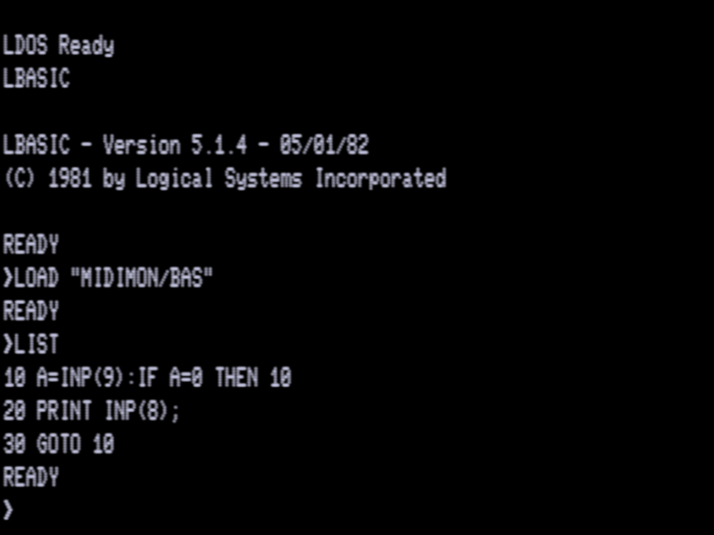
[picture p41: pics/midimon.gif]
MIDIMON
  

- `MIDITRU/BAS`: A simple MIDI SOFT THRU implementation in
  LBASIC. Simply forwards any MIDI byte received via MIDI IN DIN
  socket to either the Waveblaster, to the external MIDI OUT DIN
  socket, both, or neither, depending on the DIP switch settings (1
  and 2). Also demonstrates how to query the FIFO buffer from LBASIC,
  and how to send MIDI data from BASIC.

- `BASDRUM/BAS`: The LBASIC version of the simple drum program above, but
  unlike `DRUMS/CMD`, it's much more laggy (it's BASIC!), and it only supports
  keys 0 to 9. Unlike `DRUMS/CMD`, these keys are mapped to sensible MIDI drum
  notes on channel 10 (e.g., 0 is mapped to the bass drum, etc.)

- `NOTES/BAS`: Simple LBASIC program that demonstrates how to send
  MIDI NOTE ON and MIDI NOTE OFF messages. Plays all 127 notes of the
  Waveblaster, and/or external MIDI module, depending on the DIP
  switch settings (1 and 2).

There is also some software that was written by [George Phillips]()
that requires an Orchestra 85 (Model 1) or Orchestra 90 (Model III,
Model 4) soundcard: 

- `MIDORCM/CMD`: With this program you can play your Orchestra (85, 90)  interactively via a MIDI keyboard connected to MIDI/80's MIDI IN
socket. It is monophonic. The program is somewhat "picky" as it requires
a proper MIDI NOTE OFF message to turn of a note. Note that some
MIDI keyboards choose to send a MIDI NOTE ON message with velocity
(= "volume") 0 instead. Also, key roll-over is not implemented yet.

- `STORCH/CMD`: Allows you to play the Orchestra (85, 90) soundcard
  with your TRS-80 keyboard. The program can generate different wave
  forms (sine, square, saw, triangle), and utilizes both the left and
  the right channel of the Orchestra - each channel can be played via
  a dedicated row of keys (one octave) from your TRS-80 keyboard!
  Even the channel volumes can be changed. 

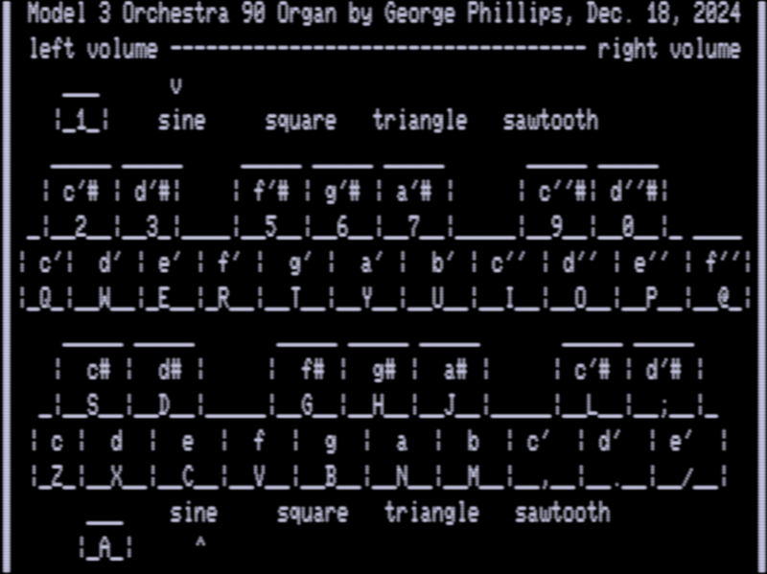
[picture p42: pics/storch.gif]
STORCH
  
  
### Creating Your Own Songs for MIDI/80 Playback 

Use the `.MID` to `.BIN` file converter. The converter is written  
in Python, and [provided as a Windows executable here.](converter/)

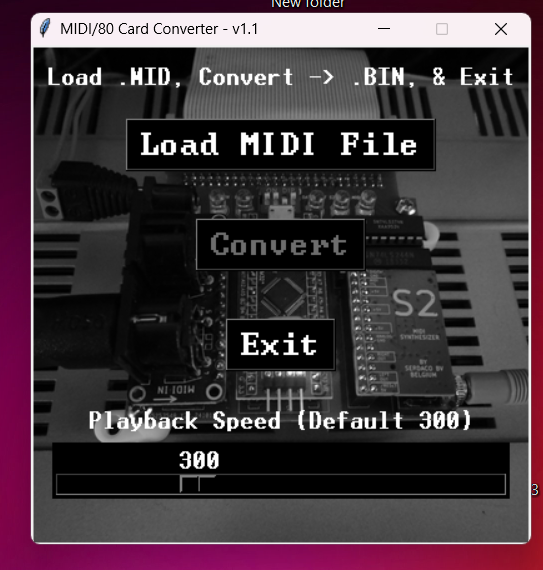
[picture p43: pics/converter1.png]
MID Converter 1


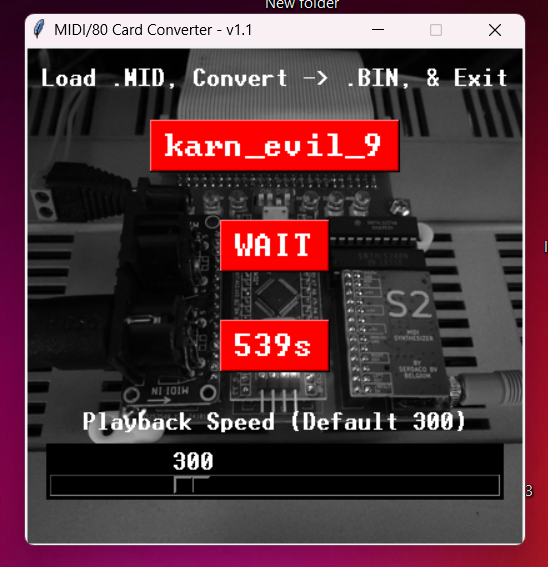
[picture p44: pics/converter2.png]
MID Converter 2


There are [a few MIDI files here you can start with](midi/).  

The converter will convert a MIDI `.MID` file into a set of 
16 KB `.BIN` fragments. A fully expanded Model 1 allows you to 
fit about ~43 KBs of song data into memory. 

In order to create your own `MYSONG/CMD` file, proceed as follows. 

1. Edit the [`CANYON.ASM`](trs-80/zmac/canyon.asm) Zmac assembly program as a blueprint. First, make a copy, give it a reasonable name, e.g., 
  `MYSONG.ASM`. 

    Then, change the line
   
       `title2		defb  '    CANYON.MID', ENTER` 

      by replacing `CANYON.MID` with your song title, e.g., `MYSONG.MID` 

2. Include as many of the the generated `.BIN` fragments of your 
   song as possible by replacing the following lines

    ```   
	incbin "./canyon0.BIN"
	incbin "./canyon1.BIN"
	incbin "./canyon2.BIN"      
    ```

    with the proper file names for your song: 

    ```
    incbin "./mysong0.BIN"
    incbin "./mysong1.BIN"
    ...
    ```

3. Next, [download and install Zmac](http://48k.ca/zmac.html) as well as [trs80gp](http://48k.ca/trs80gp.html), and assemble 
the program from the command line as follows: 

    ```     
    zmac$ ./zmac maysong.asm 
    ```

    Then, test the generated CMD / program in the `trs80gp` emulator: 

    ```     
    zmac$ ./trs80gp -ld zout/mysong.cmd
    ```

    Note that the playback program display RAM region occupied by the
    binary song data: 
    
    RAM Region
    
    The song data must stay below `$FFFF`; if the value of the display 
    end address is smaller than the start address, then the 
    memory "wrapped around" and the song data did not fit. LDOS
    will not allow loading the program in this case (as it would
    need to overwrite the ROM, which is impossible). 

Note: You can use [TRSTOOLS](http://www.trs-80emulators.com/trstools/) to add the generated `MYSONG.CMD` to a DSK image, and convert this DSK 
image into HFE format using [HxC](https://hxc2001.com/). 

## MIDI/80 Programming

Have a look at the [LBASIC demo programs on the DSK images](trs-80/model-3/), and the [`DRUMS/CMD` assembly program.](trs-80/zmac/drums.asm)

## MIDI/80 Hardware

This section provides all necessary files and information for a DIY
build of MIDI/80. Costs are in the ~35 USD range (without a
Waveblaster module; add another ~40 USD for the S2, but prices vary).

### Schematics 

[Model 1 Version (PDF)](gerbers/model-1/schematics.pdf)

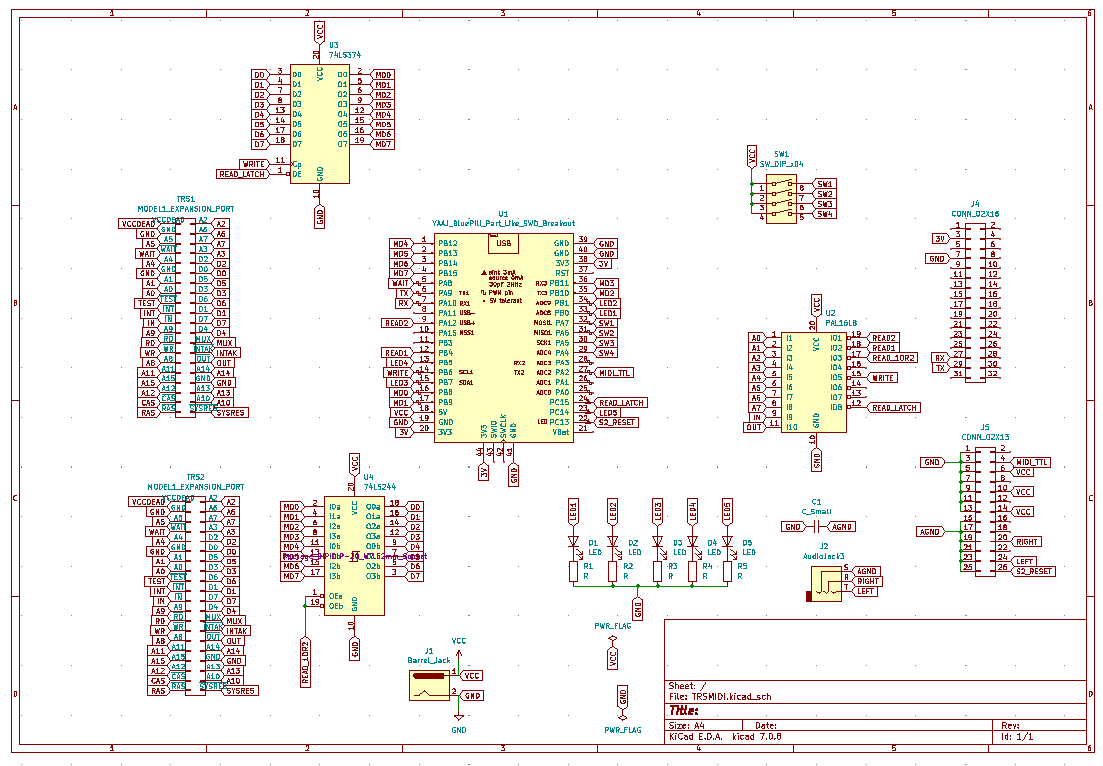
[picture p45: gerbers/model-1/schematics.png]
Schematics M1


[Model III / 4 Version (PDF)](gerbers/model-3/schematics.pdf)

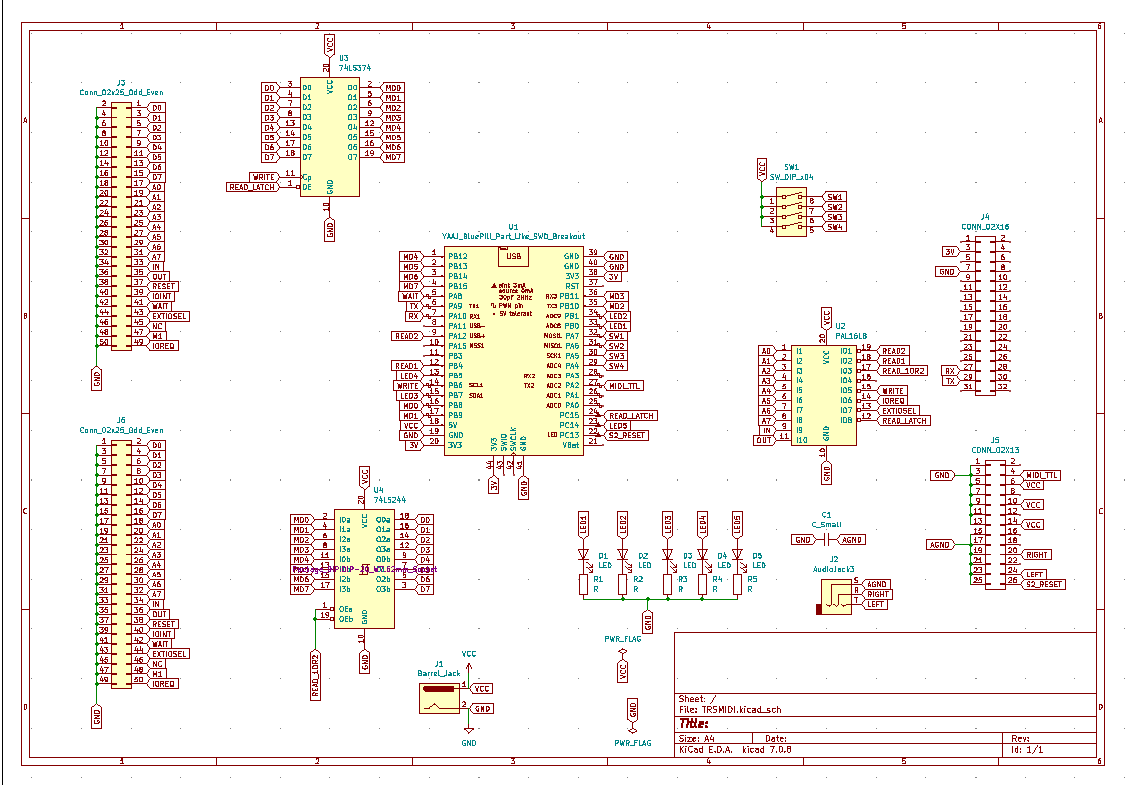
[picture p46: gerbers/model-3/schematics.png]
Schematics M1


### Bill of Material (BOM)

- 40 (Model 1) or 50 (Model III & 4) pin IDC box header 
- 40 or 50 pin ribbon cable 
- 40 or 50 pin card edge connector 
- [3.5 mm stereo jack](https://www.amazon.com/gp/product/B077D1NY4T/)
- [BluePill microcontroller](https://www.amazon.com/gp/product/B07VKSVM21/) (and ability to program / flash it, e.g., using a [ST-Link V2 BluePill programming cable](https://www.amazon.com/gp/product/B01EE4WAC8/))
- GAL16V8 + DIP socket (and ability to program it, e.g., using TL-866 MiniPro Programmer) 
- 74LS244 + DIP socket
- 74LS374 + DIP socket 
- 5 (5mm) LEDs of your liking and matching current limiting resistors (1 or 2 kOhm)
- 4-position DIP switch 
- **C1** in the schematics (and on the PCB) is actually not a capacitor, but a cable / wire bridge
- [L Type Mounting Feet](https://www.amazon.com/gp/product/B07DHHS1Q8)
- [Standard 5V DV power plug jack (5.5x2.1mm socket)](https://www.amazon.com/gp/product/B081DYQSC9/)
- [Standard 5V "wall wart" external power supply (center positive)](https://www.amazon.com/gp/product/B08722QC75)
- [Dual-row breakable pin headers](https://www.amazon.com/Cylewet-2%C3%9740Pin-Breakable-Straight-Connector/dp/B06XR2SG64) 
- Optional: [Waveblaster module](https://www.serdashop.com/RetroSoundcards)
- Optional: [Adafruit MIDI Feather](https://www.adafruit.com/product/4740) and [Single Row Straight Female Header Socket Connector for Arduino](https://www.amazon.com/gp/product/B07J5B9LT5) 

### PCB Gerbers 

The PCB Gerbers are contained in Zip archives and can directly 
be send-off to major PCB manufacturers (PCBWay, Seeed, OshPark, JLCPCB): 

- **[Model 1 Version:](gerbers/model-1/gerbers-m1-holes.zip)**

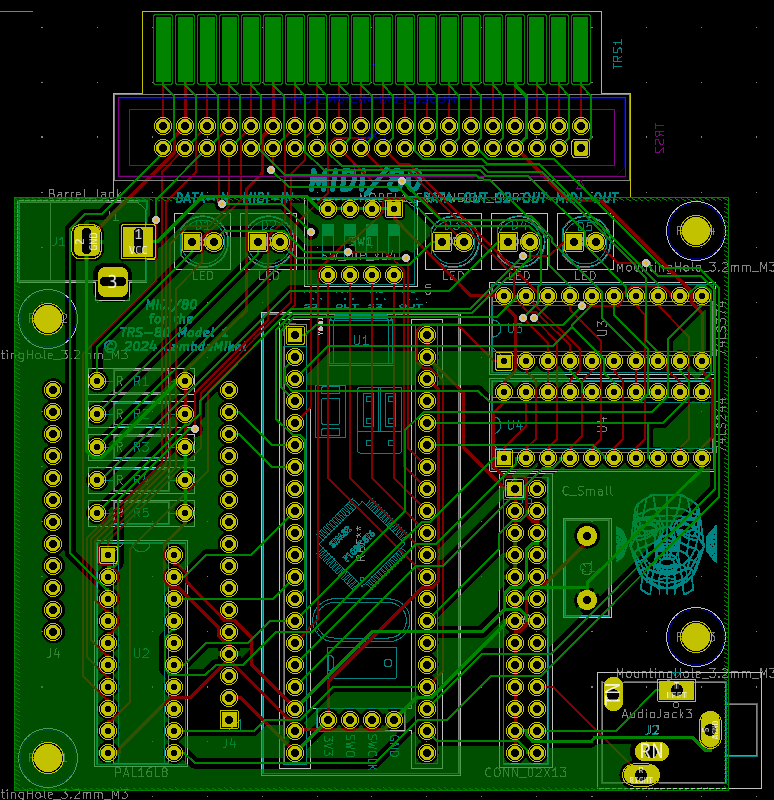
[picture p47: gerbers/model-1/pcb.png]
Model 1 PCB


- **[Model III / 4 Version:](gerbers/model-3/gerbers-m3-holes.zip)**

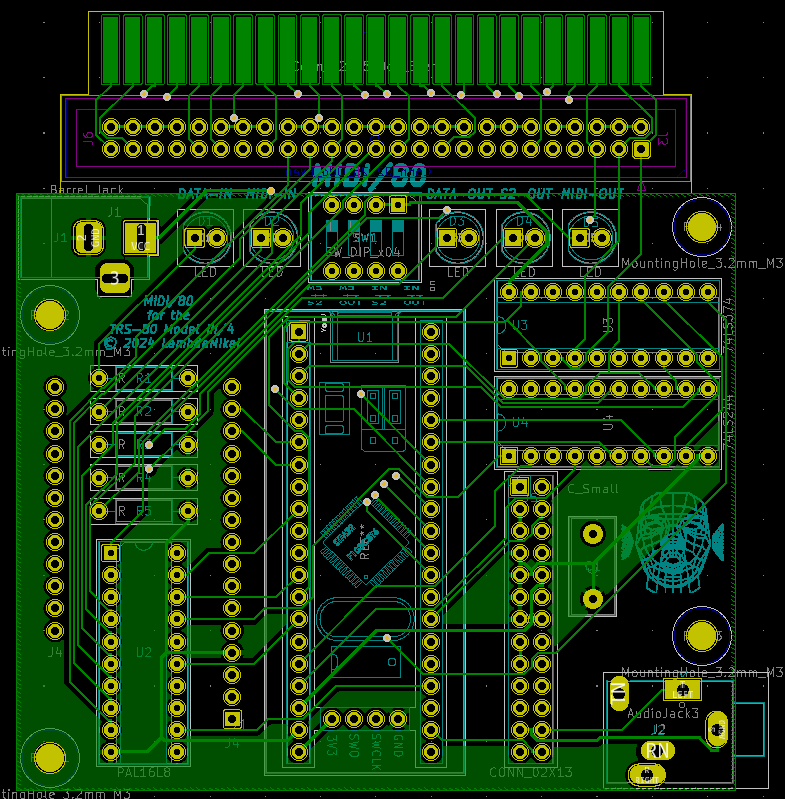
[picture p48: gerbers/model-3/pcb.png]
Model III / 4 PCB


### Assembly Notes

Note the proper IDC header orientation, i.e., the position of the "notch" differs between Model 1 and Model III / 4 version! 

- On the Model 1 version, the 40pin IDC box header notch faces **towards the edge connector.**
- On the Model III / 4 version, the 50pin IDC box header notch faces **away from the edge connector.**

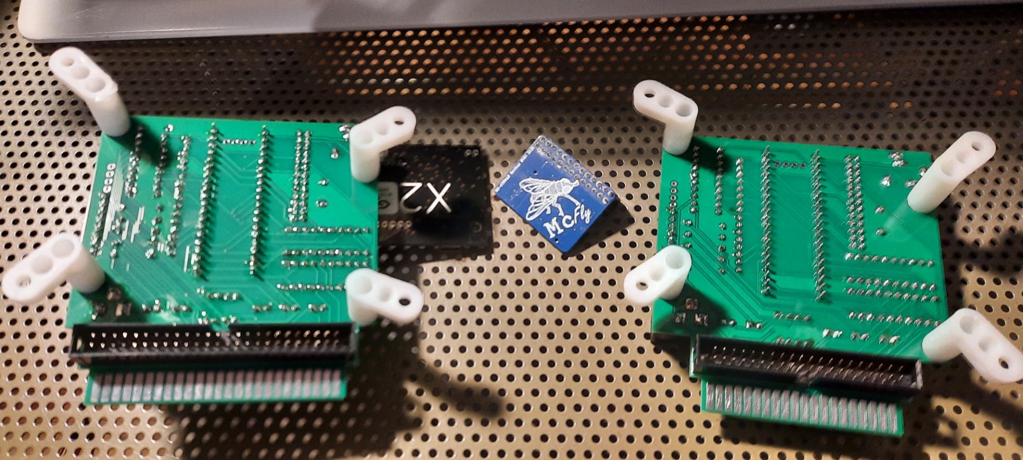
[picture p49: pics/idc-header-orientation.jpg]
IDC Box Header Notch Position


## Firmware

Here are the required firmware files for the GAL16V8 and BluePill microcontroller. 

**Model 1 Version:**
- [GAL16V8 JED firmware file](firmware/gal16v8/model-1/MIDI80-Decoder.jed) 
- [GAL16V8 PLD sources](firmware/gal16v8/model-1/TRSMIDI.PLD)

**Model III / 4 Version:** 
- [GAL16V8 JED firmware file](firmware/gal16v8/model-3/MIDI80-Decoder.jed) 
- [GAL16V8 PLD sources](firmware/gal16v8/model-3/TRSMIDI.PLD)

Installation of the STM32 FreRTOS and GCC development toolchain is explained in Warren Gay's 
book ["Beginning STM32 - Developing with FreRTOS, libopencm3 and GCC"](https://www.amazon.com/Beginning-STM32-Developing-FreeRTOS-libopencm3/dp/1484236238/), which I can recommend. 

With [the development toolchain](https://github.com/ve3wwg/stm32f103c8t6) installed and 
configured correctly, and an ST-Link V2 USB programmer  
connected, the [BluePill firmware](firmware/bluepill/) can be compiled and uploaded 
onto the BluePill simply by executing 

```
make clean
make
make flash 
```

from the command line. I am using Linux for this, even though CYGWIN is mentioned as
a possibility in the aforementioned book. 

## Acknowledgements

- [Warren Gay](https://github.com/ve3wwg/) for his book 
  ["Beginning STM32 - Developing with FreRTOS, libopencm3 and GCC"](https://www.amazon.com/Beginning-STM32-Developing-FreeRTOS-libopencm3/dp/1484236238/)
  which provided the starting point and basis for this work. 

- [George Phillips](http://48k.ca/)

- [Jürgen Wich](https://homecomputerguy.de/en/)

- [Joel Hilliard](https://www.youtube.com/@joelhilliard8298)
