lambdamikel/MIDI-80/converter/boardbw2.png

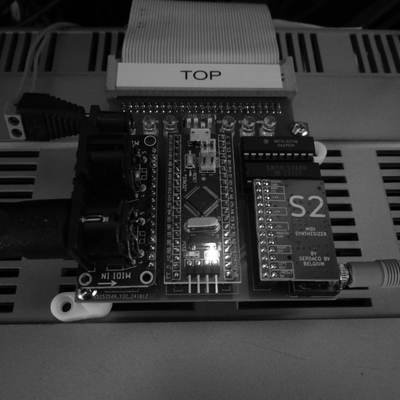
converter/boardbw2.png
