lambdamikel/MIDI-80/pics/microkorg.JPG

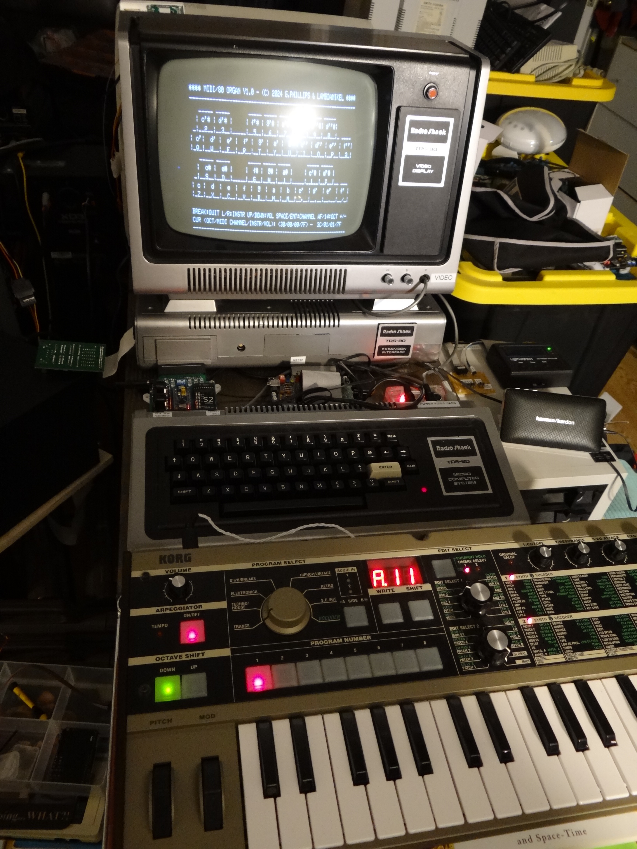
pics/microkorg.JPG
