lambdamikel/MIDI-80/pics/trs80-0.gif

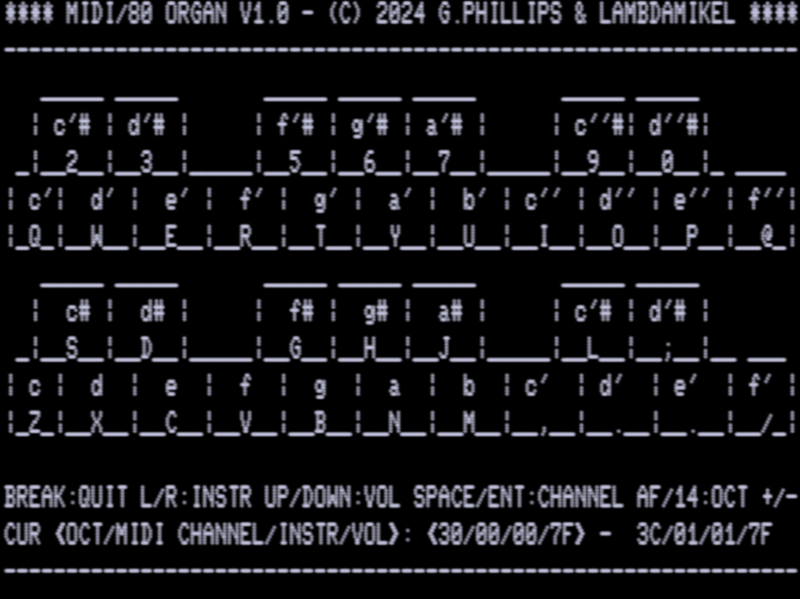
pics/trs80-0.gif
