lambdamikel/MIDI-80/gerbers/model-1/schematics.pdf

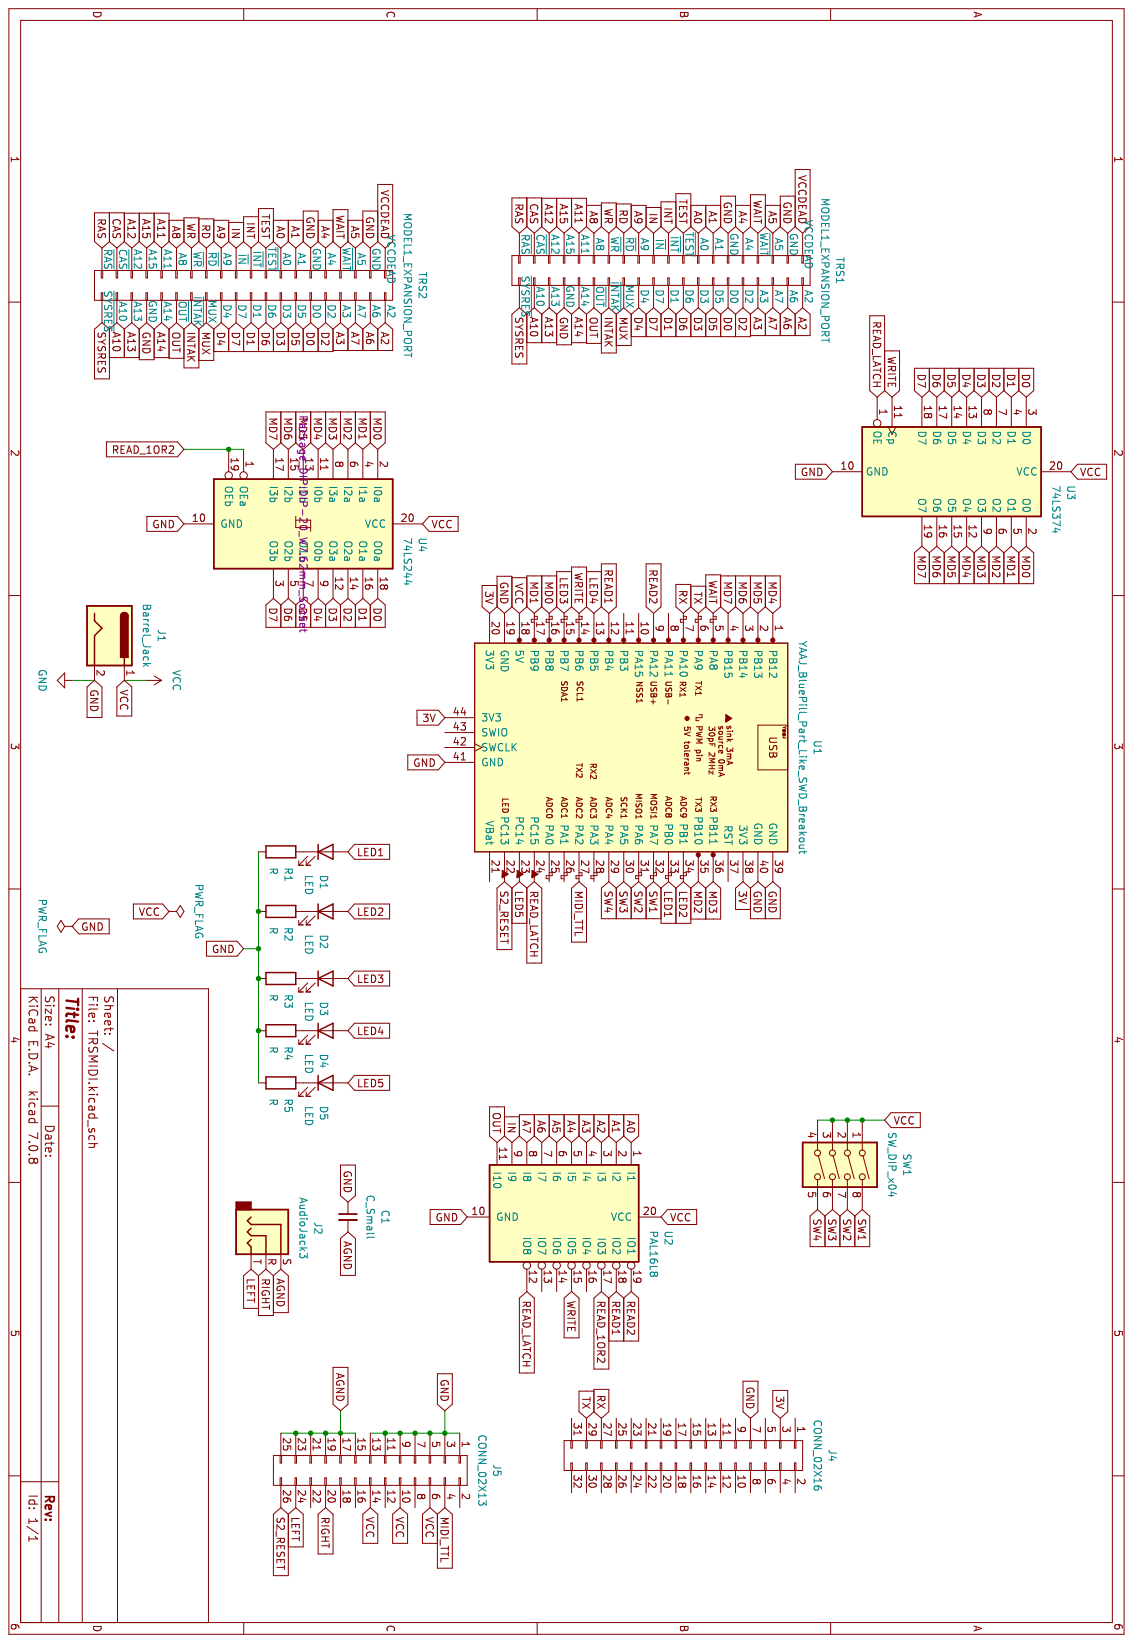
[picture p68: page 1]
