lambdamikel/MIDI-80/gerbers/model-3/schematics.pdf

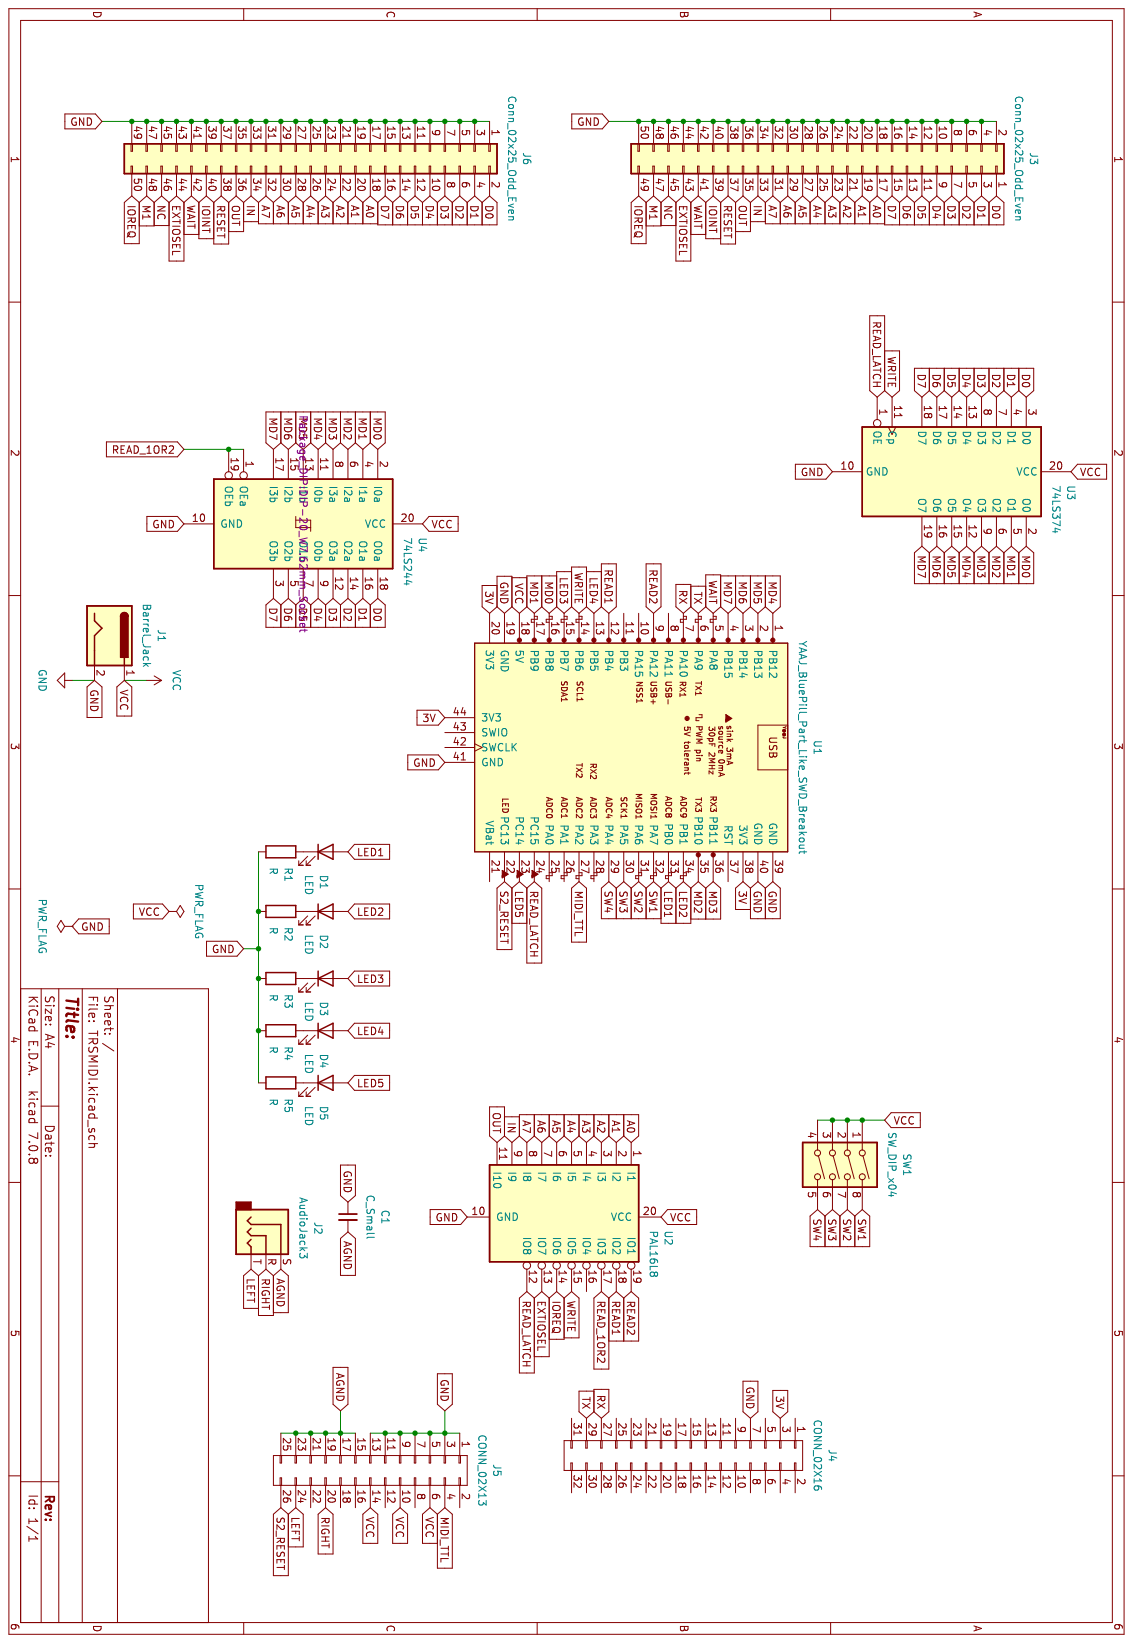
[picture p69: page 1]
