lambdamikel/MIDI-80/(commit log)

2024-12-28 Drum Tracker Version 1.4 - see tracker1.cmd on the DSK / HFE images. This now allows realtime MIDI recording over drum channel 10; note (drum) numbers of MIDI NOTE ON message for the drums are record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
2025-03-08 TRACKER 1.60 - Multiple Patterns supported! Song mode (= patter chaining) soon.
2025-03-08 TRACKER 1.60 - multiple patterns. Clear pattern, copy pattern, pattern change in realtime. Song mode (pattern chaining) soon. Patterns A-Z can be changed in realtime.
2025-03-10 TRACKER 1.70 - SONG MODE WORKING! Check out "&", and "!" and "T" while song is playing (realtime song pattern recording). Use "*" for loops in song mode; "." stops the song. 64 slots for patterns (A-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
2025-03-28 Tracker updat e- MIDI external clock over printer port! BIT 0 <-> BUSY, GND connection. Works for Model I and Model III.
2025-03-28 Tracker 5 - external printer clock.
2025-03-29 External parallel port cable clock working. Use GND <-> GND, Bit 0 (1st 1) output <-> BUSY INPUT.
2025-03-30 Fixing an annoying UI bug - leaving copy pat, clear page, help page or song editor via ENTER no longer inputs a stray note at the current pattern position.
2025-03-30 Tracker 1.98 - my Model 4 couldn't read the BUSY signal from the printer port via IN a, (&f8), but reading the status from memory-mapped address ld a, (&37E8). This may be a bug in my Model 4, or not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
2025-09-27 README update - Joel Tandy Assembly 2025 Talk about MIDI/80.
2026-09-07 TRACKER 1.99 / 2.00: MIDI clock + MMC transport output, faster core
    EXPERIMENTAL - developed and measured entirely under emulation
    (trs80gp cycle accurate bus trace). Not yet run on real hardware.
    TRACKER5/CMD (V1.98) is unchanged and remains the known good version.
    TRACKER 1.99 (tracker6.asm) - MIDI master output, 1.98 core otherwise:
    - New 'R' key toggles MIDI sync out; 'M' shows in the status row.
    - Start sends FA + MMC Play (F0 7F 7F 06 02 F7); stop sends FC + MMC
    Stop (F0 7F 7F 06 01 F7); F8 timing clock at 24 ppqn while playing.
    - A step is a 16th note, so exactly 6 clocks are emitted per step and
    the count is drift free by construction.
    - Sending, not receiving: the main loop's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
2026-09-07 TRACKER: R now cycles four MIDI sync modes instead of on/off
    The previous single toggle armed clock, transport and MMC together,
    and the in-program help said only "MIDI SYNC" - so there was no way to
    tell from the machine that MMC was being sent at all, and no way to
    send MMC without also sending a timing clock.
    That distinction matters: MMC is ignored by gear that does not speak
    it, but a timing clock is not - anything set to external sync starts
    following this machine's tempo the moment the clock appears. Wanting
    the P key to roll a DAW's transport while something else remains the
    timing master is a real setup, and it was unreachable.
    R now cycles, with the mode shown as one character in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
2026-09-07 firmware: external MIDI clock box for TRACKER (Arduino Uno + MIDI shield)
    Converts incoming MIDI beat clock into the parallel port step pulses
    TRACKER already accepts in external clock mode ('), so a DAW or drum
    machine can drive a TRS-80 running TRACKER.
    TRACKER cannot recover an incoming clock itself: profiling showed a
    ~27 ms contiguous work block per step during which it never reads the
    MIDI/80 FIFO, and at 120 BPM an F8 arrives every 20.8 ms. At least one
    clock per step therefore lands in a blind window - the FIFO keeps the
    bytes but loses their arrival times, and clock recovery needs
    timestamps. A dedicated ATmega328 does nothing else.
    Behaviour:
    - Counts F8 and toggles the output ev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
2026-09-07 docs: README for the external MIDI clock box
    The main README linked to firmware/midiclock-uno/ but the directory had
    no README of its own, so the link only showed a bare file listing.
    Covers the rationale, wiring table, usage, divisor jumpers, the
    shield-switch gotcha that blocks uploads, the hardware verification
    results, and the edge-only transport limitation.
    Claude-Session: https://claude.ai/code/session_01NYwNLJv4mWCnQH4g3MmoLD
2026-09-07 midiclock: support free-running masters, verified against a microKORG
    Many devices with an internal clock stream F8 continuously and never
    send FA/FB/FC at all. A Korg microKORG on INT clock does exactly this:
    measured here as 55 F8 per second (~138 BPM) with zero transport bytes
    in 45 seconds, and the clock keeps running whether or not the
    arpeggiator is playing. The box waited for a Start and therefore
    ignored a perfectly good clock.
    Now: if the master has never sent a transport message, 24 steady clocks
    (one quarter note) are taken to mean "running". Once any FA/FB/FC or
    MMC transport byte has been seen, transport is obeyed strictly for the
    rest of the session - so free-running gear work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
2026-09-07 docs: pin assignment table, resistor rationale, and the MIDI sniffer
    A documentation audit turned up several gaps.
    - Full GPIO pin assignment table: D0/D1 MIDI UART, D8 step clock, D9/D10
    divisor jumpers, D13 indicator, GND. Previously the pins were
    scattered across three sections and the jumper pins were only
    mentioned in passing.
    - The series resistor now has a rationale rather than being an
    unexplained aside: D8 is push-pull and can source or sink ~20 mA, so
    if it ever lands on a TRS-80 output (mis-counted connector, bent pin)
    the resistor limits the fight to a few mA. It costs nothing in signal
    integrity since the TTL input draws no current.
    - ASCII wiring diagram, and a n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
    [midisniff.ino]
2026-09-07 docs: add a photo of the built clock module
    Shows the Uno clone with the MIDI shield stacked, both DIN sockets, and
    the slide switch - which is worth a picture because it is the single
    most confusing part of using the board: it gates D0/D1, so it must be
    OFF to upload and ON to receive MIDI, and the failure mode in each
    position is an unhelpful avrdude not-in-sync message.
    Embedded at the top of the clock box README and referenced from the
    clock box paragraph in the main README, which was otherwise the only
    text-only section in an illustrated document.
    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
2026-09-07 docs: shield close-up, and correct the IN socket claim from silkscreen
    The wide shot could not resolve the socket labels, so the previous
    caption asserted the cable was in the IN socket by inference - it worked,
    therefore it must be IN. The close-up shows the silkscreen directly:
    IN, OUT and THRU, with the cable in IN. Claim is now read rather than
    deduced.
    The close-up also explains a behaviour we relied on without
    understanding it. The slide switch is silkscreened RX(S2), not "MIDI":
    it gates the RECEIVE line only, leaving TX permanently connected to both
    the MIDI OUT socket and the USB converter. That is why uploads fail with
    it ON, and equally why the TEST_ECHO build could report every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
2026-09-07 Bootable LDOS disk images with TRACKER 1.99 and 2.00, plus the writer
    Adds ready-to-run images carrying TRACKER5/CMD (1.98), TRACKER6/CMD
    (1.99) and TRACKER7/CMD (2.00) together, so old and new can be compared
    on the same machine without swapping disks:
    Model III/4 trs-80/model-3/dsk/TRACKER.DSK (JV3)
    trs-80/model-3/hfe/TRACKER_DSK.hfe
    Model I trs-80/model-1/dsk/tracker.dsk (JV1)
    trs-80/model-1/hfe/tracker_dsk.hfe
    tools/ldoswrite.py inserts files into an existing bootable LDOS image in
    place, with no emulator and no Wine. It exists because the documented
    tool for this, trswrite.exe from Matthew Reed's TRSTOOLS, is a Windows
    binary whose original do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
2026-09-07 docs: consolidated measured-improvements tables in the README
    The figures were scattered through the prose; this gathers them into
    three tables - timing stability, raw speed, and the clock box - so the
    before/after is readable at a glance.
    Adds numbers that were not written down anywhere: step period standard
    deviation 1.96 -> 0.46 ms, showplaycursor 16259 -> 2818 T, work per step
    63.53 -> 41.40 ms, tempo shift when sync is enabled 17.9% -> 0.1%, BPM
    readout error 0.17%, code size +808 bytes, and the clock box ratios
    (46x tighter than TRACKER's own output, 281x tighter than its blind
    window).
    Keeps the caveats attached to the numbers rather than buried: the 4.3x
    step stability figure rests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
2026-09-08 Three demo songs for TRACKER, with disk images and MIDI renderings
    BOOGIE is a 12 bar blues shuffle in C (bass, two organ voices, lead
    guitar, two drum tracks), SEQUENCE a Berlin school 16th note sequencer
    piece in A minor that builds over five patterns, and DRUMS a six voice
    drum machine with every track on channel 10 - which is TRACKER back in
    the shape it started life as.
    Each ships as a bootable JV3/JV1 disk that also carries TRACKER7/CMD,
    plus HFE for Gotek/HxC, for both Model I and Model III. Since TRACKER
    always reads a file called DUMP, one song needs one disk. The Model I
    image had a single free granule, so TRACKER5/6, the BASIC overlays and
    DATECONV were removed to make room; ldos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
2026-09-09 Screenshots of the three demo songs playing
    One per song, captured from trs80gp mid playback on a Model III, matching
    the single frame 800x599 GIF convention of the existing pics.
    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
2026-09-09 TRACKER 2.00: stop @KEY racing the direct keyboard scan
    Reported from real hardware: pressing H flashes the help page for a
    fraction of a second and then loses it. It looks like contact bounce but
    is not - it reproduces exactly under emulation, which simulates no bounce
    at all, and the threshold gives it away. A press held 2 to 4 frames keeps
    the page; 8 frames or more always loses it.
    2.00's direct matrix scan reacts to a key in about a millisecond, while
    the interrupt driven DOS keyboard driver only scans every 25 ms or so.
    Any press held longer than one DOS scan is therefore queued in the DOS
    type ahead buffer as well, and help's call @KEY reads that buffer and
    gets back the very H that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
2026-09-09 TRACKER 1.99 / 2.00: stopping now silences the notes
    Reported from real hardware: stop a song and the notes hang until the S2
    is reset. The MIDI panic itself is fine - that is the 0 key, and it works
    on the S2; @ is "set current track drum note to last MIDI note", which is
    what the help page has said all along.
    The real defect is that stopping never sent any note offs. Both stop
    paths, showstartstop (the P and ! keys) and stopsong (a song reaching '.'
    in the song row), sent only the FC transport byte and set the status
    flag. Any note whose note off was scheduled for a later step never
    received one and sounded forever. showplay does call midipanicr on the
    way in, which is why starting again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
2026-09-09 docs: tempo calibration confirmed on real hardware
    Eight bars of BOOGIE pattern A timed at 13 to 14 seconds on a real Model
    III. The calibration here predicts 13.73 s; the tracker's own BPM:130
    readout implies 14.69 s. The measured window contains the first and
    excludes the second, so the readout reading ~7% slow is a real property
    of the program and not an emulation artifact.
    Also notes why correcting it is not a one line constant change:
    steptarget is what the step accumulator is compared against, so moving
    TEMPOBASE would shift the actual tempo as well as the display. An honest
    fix derives the displayed BPM from the measured relation and leaves
    steptarget alone.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
2026-09-09 docs: tempo calibration confirmed on real hardware over 32 bars
    Four repeats of BOOGIE pattern A - 32 bars, 512 steps - timed at 55.0 s
    by stopwatch on a real Model III, against 54.94 s predicted, implying
    ~139.6 BPM against 139.8. Allowing a few tenths of reaction time at each
    end that is agreement to within about half a percent.
    The tracker's own BPM:130 readout implies 58.8 s for the same passage,
    nearly four seconds out and far beyond stopwatch error, so it is excluded
    outright. The emulator derived relation actual = 62778 + 1547.9 * tempo
    T-states holds on real silicon and the BPM field reads ~7% low.
    Claude-Session: https://claude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
2026-09-09 docs: 2.00 is the version to use now, and what that means on stage
    The hardware-tested banner was immediately followed by a line telling
    people to stick with 1.98 for actual music work until 1.99 and 2.00 were
    validated. They have been, so that line now contradicts the banner above
    it and points users at the wrong version.
    Also adds the practical framing that the technical sections never state:
    until now a TRS-80 running TRACKER was an island on stage, keeping its
    own time with nothing able to lock to it. Clock output makes it the
    master of the rig, M mode covers the reverse case, and the jitter numbers
    matter because they are the difference between staying locked to a drum
    machine across a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
2026-09-09 docs: BPM calibration confirmed on a real Model I too
    32 bars of BOOGIE timed at 63.0 s on a real Model I against 63.4 s
    predicted by the Model I fit, reading BPM:121 against a true 121.9. With
    the Model III result (55.0 s against 54.94 s, BPM:140 against 139.6) both
    machines are now confirmed on hardware.
    The old readout would have implied 67.2 s on the Model I, excluded
    outright, just as 58.8 s was on the Model III.
    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
2026-09-09 docs: Model I, the keyboard fixes and MIDORG V1.1 all hardware confirmed
    Leaves only two things unverified on real hardware: the .hfe images on a
    Gotek, and the external clock cable from the Arduino module into the
    parallel port, which has not been built yet.
    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
2026-09-09 docs: the HFE images are hardware confirmed on both machines too
    Booted from a Gotek on a real Model III and a real Model I. That leaves
    only the Arduino clock box's cable into the parallel port unverified, and
    only because it has not been built yet.
    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
2026-09-09 docs: correct the stale BPM formula comment above calcbpm
    The header still documented BPM = 1900800 / steptarget, which is exactly
    the thing the readout fix stopped doing. Now records that bpmdiv holds
    the measured period instead, and why midiclkadd deliberately still uses
    steptarget: the step boundary and the clock run off the same biased time
    base, so the bias cancels and 6 clocks land per step regardless. That one
    must not be 'fixed'.
    Comment only - the assembled binary is byte-identical, so the disk images
    are already correct.
    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
2026-09-09 docs: 2.00's wait-state worry did not materialise on real hardware
    The passage still asked people to test 2.00 before relying on it and to
    fall back to 1.99 if disabling video wait states produced hash on a real
    CRT. It has since been run on a Model III and a Model I and the display
    is clean, so that now records the result instead of the worry. A Model 4
    has still not been tried and the wait state bit is a Model III/4 thing,
    so that caveat is kept, narrowed to the machine it applies to.
    The no-typematic-repeat note was still accurate but incomplete: it did
    not mention the ~20 ms release settle added after real hardware showed
    command keys double firing on contact bounce.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
2026-09-11 MIDORG attribution, and a README spelling pass
    MIDORG's title line now reads LAMBDAMIKEL+G.PHILLIPS+CLAUDE, matching the
    CPC version: the program is Michael Wessel's, with George Phillips'
    keyboard scanner, artwork and highlighting. The string is the same 64
    columns, so the CMD is the same 3146 bytes and the two disc images that
    carry V1.1 were patched in place rather than rebuilt. Verified by
    extracting MIDORG/CMD back out of both images and comparing against the
    freshly assembled binary - identical, byte for byte. The matching HFEs
    were regenerated. midi2.dsk still carries the older V1.0 build and was
    left as it is.
    README spelling, thirteen fixes:
    capabale -> capable connte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
2026-09-12 Document the MIDI IN recording gotcha
    TRACKER records NOTE ON and ignores NOTE OFF; a note's length comes from
    the Gate Time. While recording, the echo to MIDI OUT only sends the NOTE
    OFF when the next note arrives, so the last note played keeps sounding -
    inaudible with a piano, a drone with an organ. Playback is unaffected.
    Also noted that a keyboard sending NOTE ON with velocity 0 in place of a
    NOTE OFF gets its key releases recorded as extra notes, the same pickiness
    MIDORCM/CMD already documents.
    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
2026-09-12 MIDI IN: honour NOTE OFF while recording
    TRACKER accepted only $90 and discarded everything else, so a key release
    never reached the parser. The recording echo therefore held a note until
    the NEXT one arrived - inaudible on a piano, a drone on an organ - and a
    keyboard that sends NOTE ON with velocity 0 in place of a NOTE OFF had
    every key release recorded as a second note.
    The parser now accepts $80 as well, treats velocity 0 as a release, keeps
    running status across messages, and steps over system real time bytes so
    that active sensing can no longer cut a message in half.
    No new variable: the data segment IS the song file, and a byte added there
    would move every offset in it, on both mac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
2026-09-12 Rebuild TRACKER7/CMD and the disk images with the NOTE OFF fix
    tools/ldoswrite.py rewrites the file in place in all eight images that
    carry it - four Model III (JV3) and four Model I (JV1) - deleting it first,
    which the Model I disks need since they have one free granule left. hxcfe
    regenerates the .hfe files from the .dsk images, as documented in
    tools/README.md.
    Verified: the binary reads back out of all eight images byte for byte, and
    a sector level diff against the previous images shows every change confined
    to the directory track and TRACKER7/CMD's own granules - the LDOS system
    files and the song DUMPs are untouched.
    Claude-Sessio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
2026-09-15 README: put the clock box wiring where people look for it
    The two wires and the 220-470 ohm series resistor were only in
    firmware/midiclock-uno/README.md; the main README linked to the clock box
    three times without saying the wiring was in there. Summarised at the point
    of use, with the reuse-the-sync-cable shortcut, still linking out for the
    full pinout and the jumpers.
    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
2026-09-15 #septandy 2026: the external clock box works on real hardware
    The last unproven path in the system is proven - a microKORG drives TRACKER
    on a real Model I through the clock box and the parallel port. New news
    entry with the video and two photos, the photos also on the clock box page,
    and the entry in Demo Videos.
    The note saying the clock cable "has not been built yet" is gone, and the
    clock box paragraph now says it has been used in place, not only measured
    on the bench.
    The photos are re-encoded rather than committed as they came off the phone:
    EXIF stripped (both carried GPS coordinates), the portrait one's rotation
    flag baked in so it cannot render sideways, and both scaled to 2000 px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
2026-09-15 Strip GPS coordinates from the photos in the repo
    Eight photos carried the location they were taken at. Now none do.
    Five of them (idc-header-orientation, midi80-4, waveblasters, and the two
    in firmware/midiclock-uno) were rewritten losslessly: the APP1 segment is
    dropped and the entropy coded scan copied byte for byte, so the pixels are
    provably identical to what was committed before.
    Three (short-cable1, short-cable2, microkorg) carried an orientation flag,
    and dropping that without rotating the pixels would have left them sideways
    on GitHub. Those were re-encoded at quality 95 with the rotation baked in -
    same displayed size, mean pixel difference under 0.1 of 255.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
2026-09-16 Never leave notes hanging at the end of a song, or on quit
    Two ways TRACKER could stop while notes were still sounding.
    At the end of a song, getsongpat reaches '.', calls stopsong, which sets
    status to 0 and panics - and then nextstep1 called playnotes anyway, so the
    step's notes went out AFTER the panic and their note offs were scheduled by
    a playback that was no longer running. Captured on the wire at the end of
    BOOGIE: four note-ons after the last panic byte, still sounding three
    seconds later. playnotes is now skipped when playback has stopped.
    Quitting simply never panicked: Q went straight to the Y/N prompt and then
    to the exit, leaving whatever was sounding to sound forever. It pan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
